nicelight/Brain_Ring-/left_right_buttons/GyverPanelWiFi-master/pcb/lamp8266.png

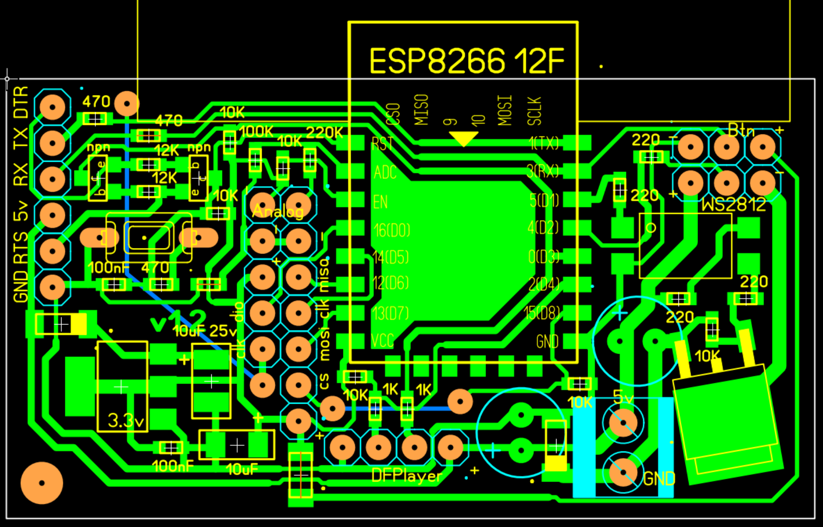
left_right_buttons/GyverPanelWiFi-master/pcb/lamp8266.png
