nicelight/Brain_Ring-/left_right_buttons/GyverPanelWiFi-master/proj_img.jpg

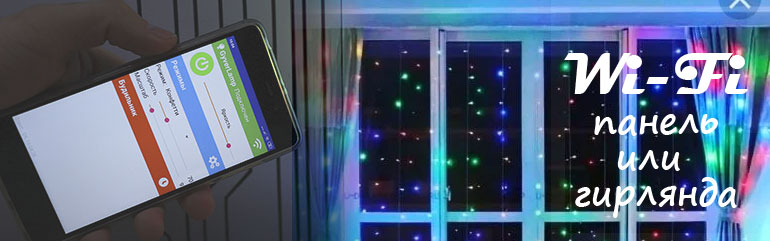
left_right_buttons/GyverPanelWiFi-master/proj_img.jpg
