nicelight/Brain_Ring-/left_right_buttons/GyverPanelWiFi-master/schemes/convertor.png

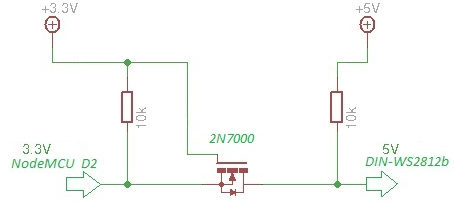
left_right_buttons/GyverPanelWiFi-master/schemes/convertor.png
