nicelight/Brain_Ring-/left_right_buttons/GyverPanelWiFi-master/schemes/ESP32_ALL.JPG

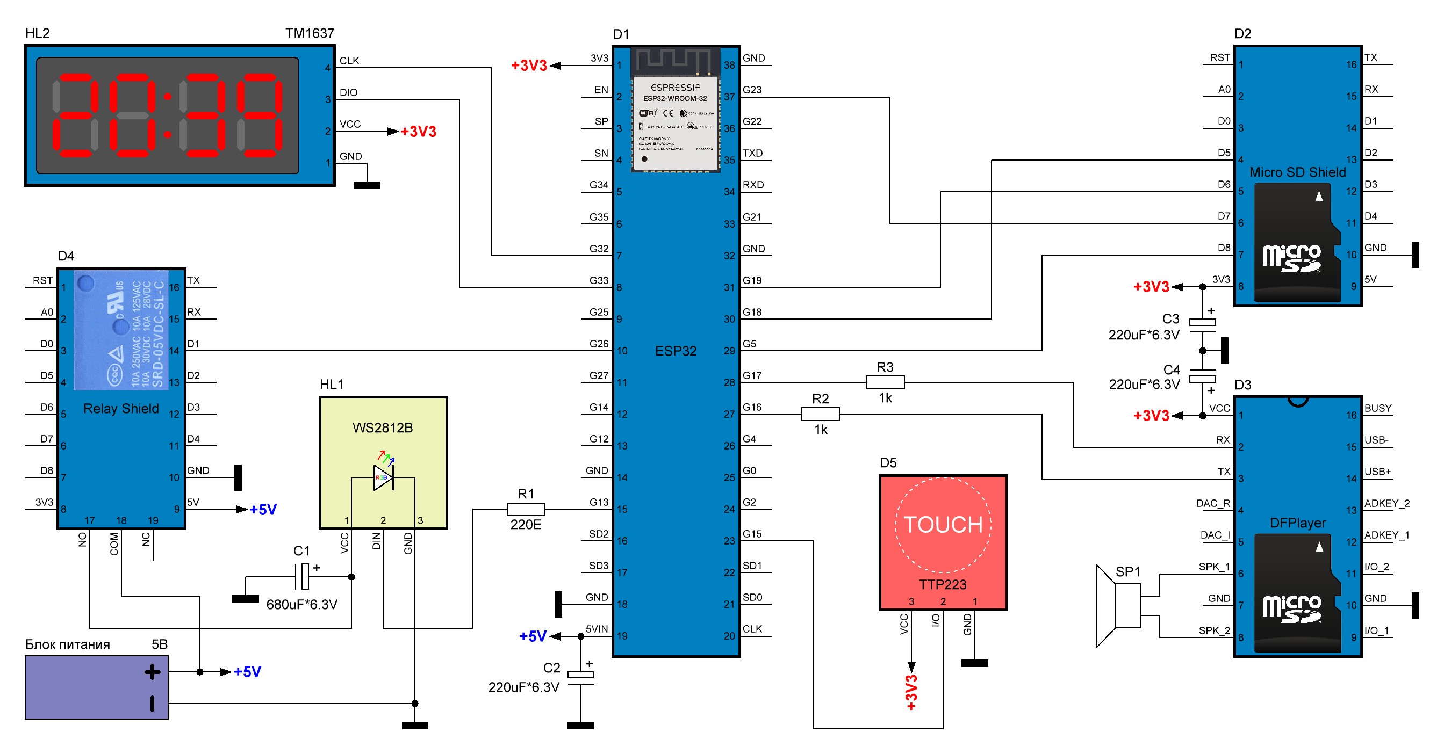
left_right_buttons/GyverPanelWiFi-master/schemes/ESP32_ALL.JPG
