nicelight/Brain_Ring-/left_right_buttons/GyverPanelWiFi-master/schemes/ESP32_button_noRELAY.jpg

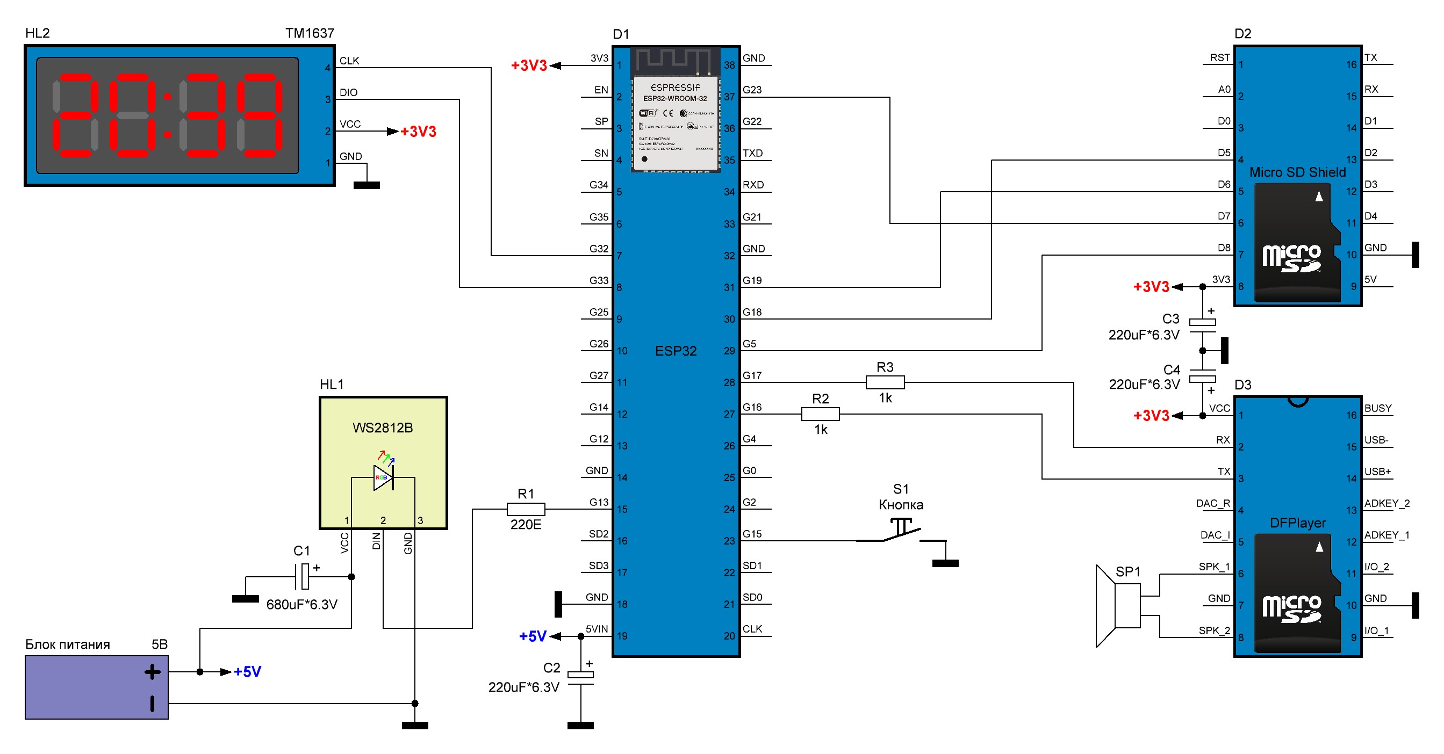
left_right_buttons/GyverPanelWiFi-master/schemes/ESP32_button_noRELAY.jpg
