nicelight/Brain_Ring-/left_right_buttons/GyverPanelWiFi-master/schemes/ESP8266_ALL.jpg

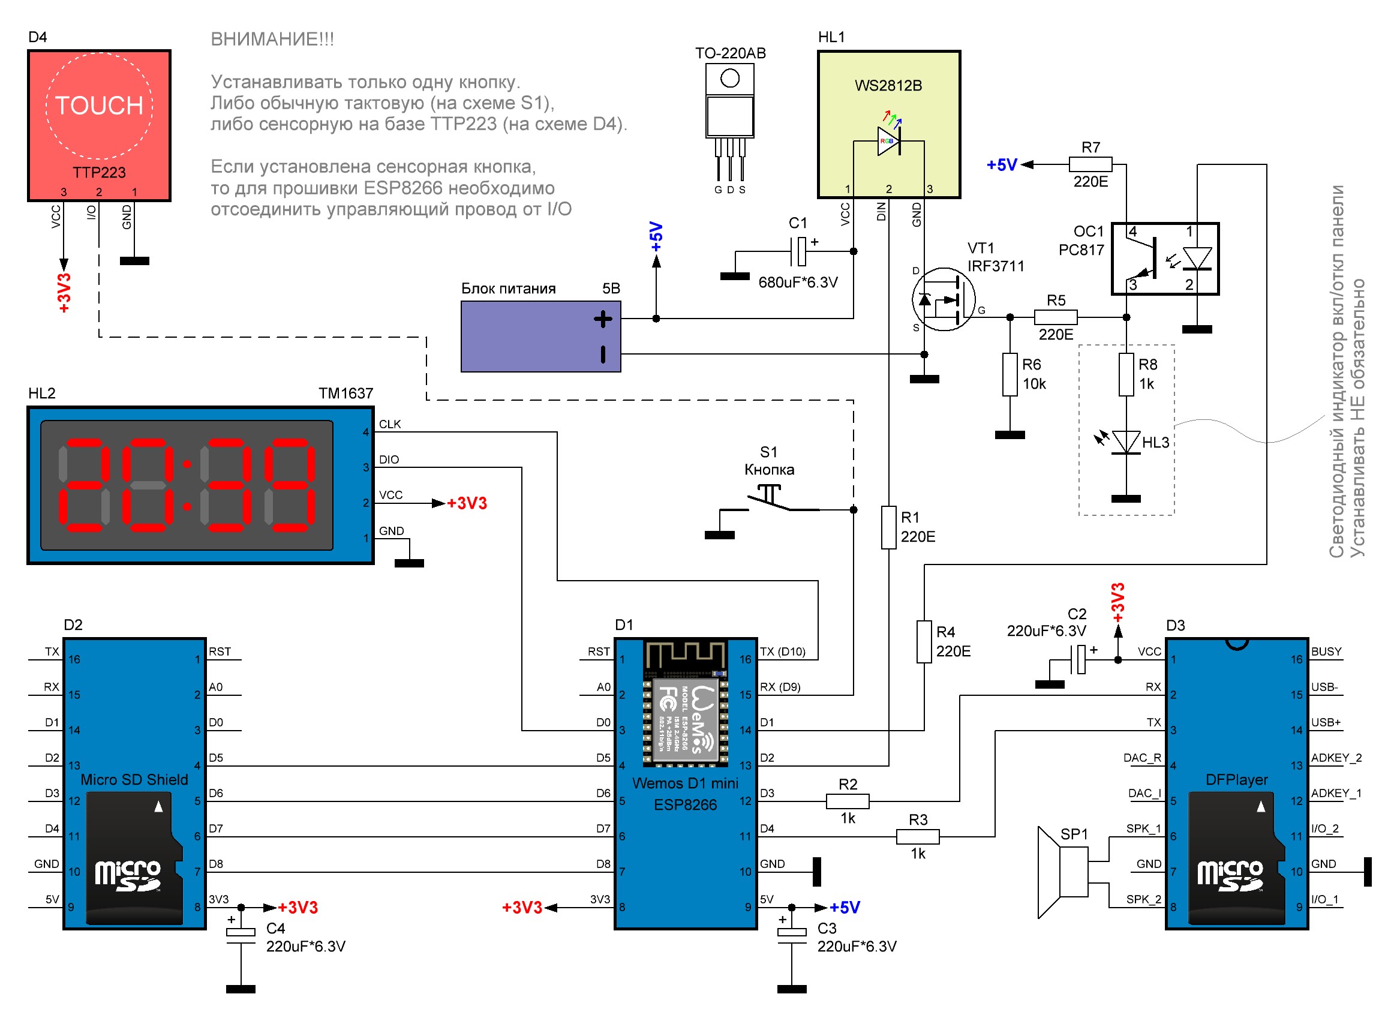
left_right_buttons/GyverPanelWiFi-master/schemes/ESP8266_ALL.jpg
