nicelight/Brain_Ring-/left_right_buttons/GyverPanelWiFi-master/schemes/ESP8266_RELAY.jpg

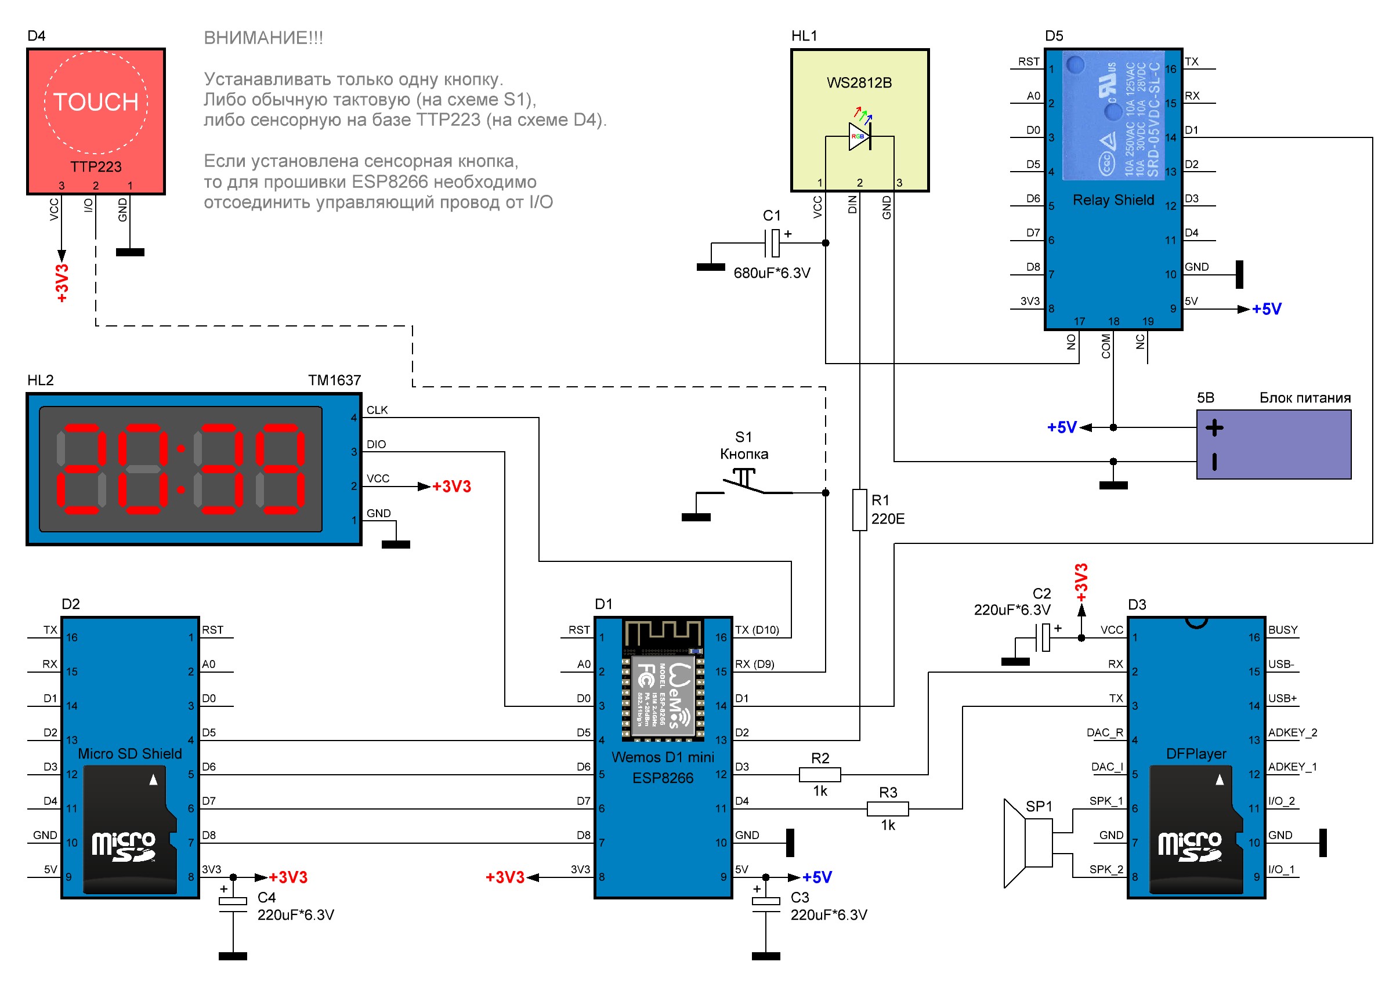
left_right_buttons/GyverPanelWiFi-master/schemes/ESP8266_RELAY.jpg
