nicelight/Brain_Ring-/left_right_buttons/GyverPanelWiFi-master/schemes/mosfet2.jpg

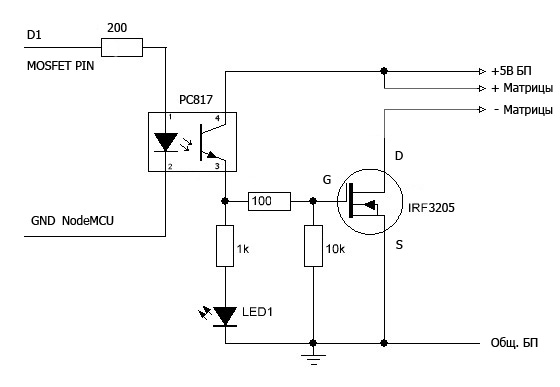
left_right_buttons/GyverPanelWiFi-master/schemes/mosfet2.jpg
