nicelight/Brain_Ring-/left_right_buttons/GyverPanelWiFi-master/schemes/mosfet.jpg

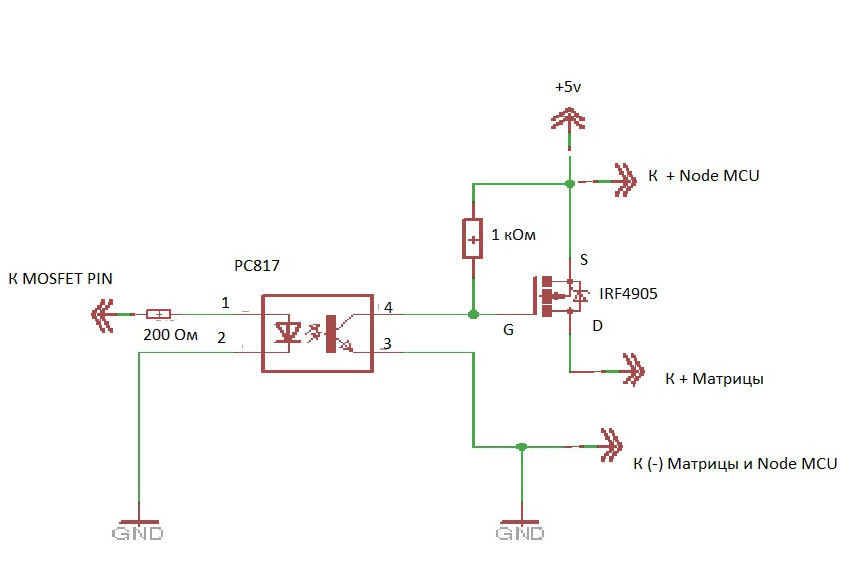
left_right_buttons/GyverPanelWiFi-master/schemes/mosfet.jpg
