nicelight/Brain_Ring-/left_right_buttons/GyverPanelWiFi-master/schemes/nodemcu.png

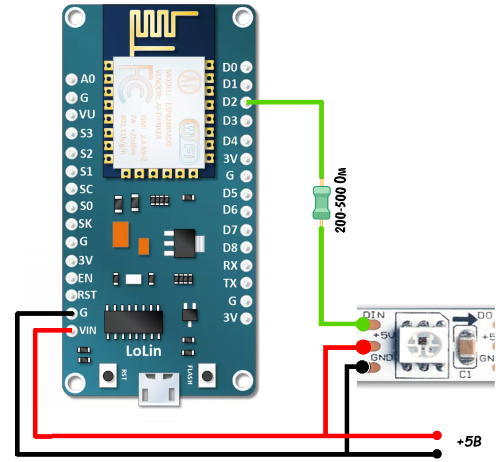
left_right_buttons/GyverPanelWiFi-master/schemes/nodemcu.png
