nicelight/Brain_Ring-/left_right_buttons/GyverPanelWiFi-master/schemes/scheme1,1.jpg

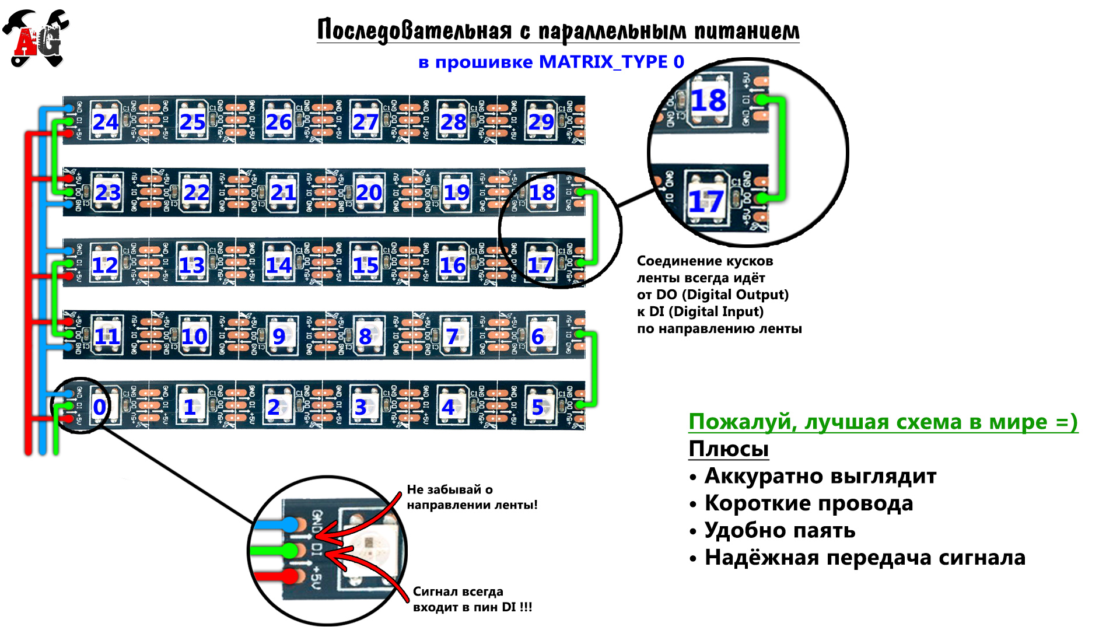
left_right_buttons/GyverPanelWiFi-master/schemes/scheme1,1.jpg
