nicelight/Brain_Ring-/left_right_buttons/GyverPanelWiFi-master/schemes/scheme3.jpg

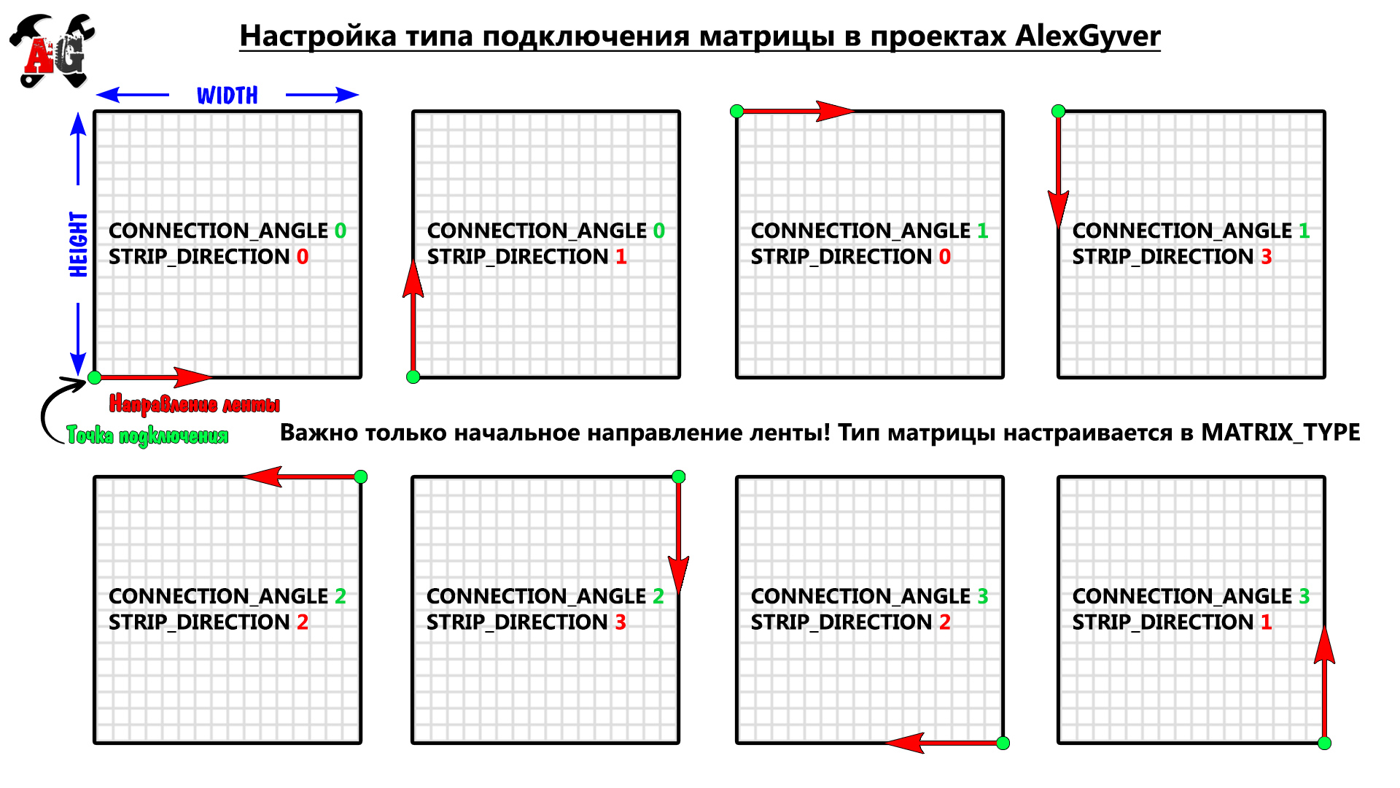
left_right_buttons/GyverPanelWiFi-master/schemes/scheme3.jpg
