nicelight/Brain_Ring-/left_right_buttons/GyverPanelWiFi-master/schemes/scheme.jpg

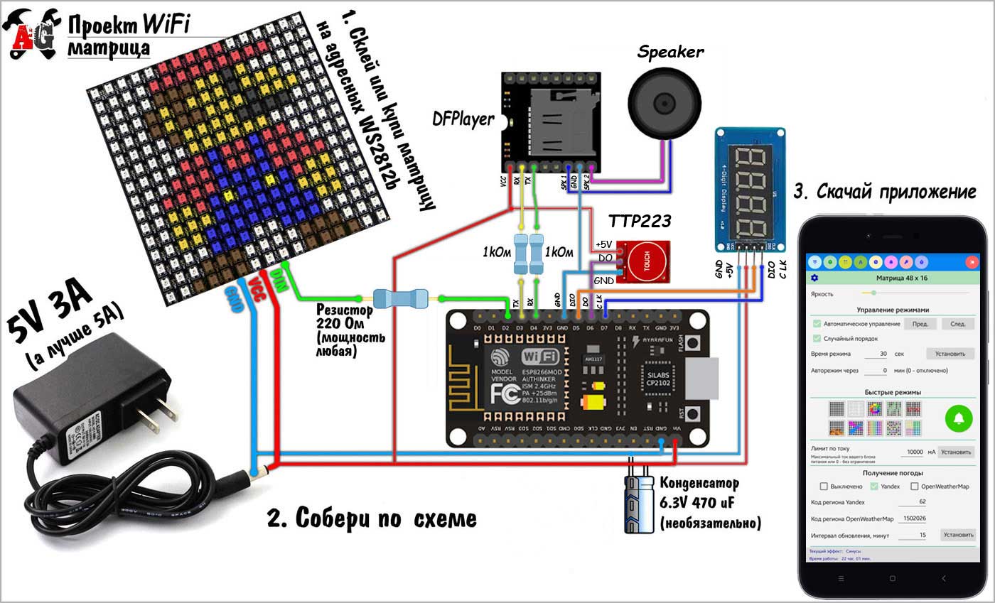
left_right_buttons/GyverPanelWiFi-master/schemes/scheme.jpg
