nicelight/Brain_Ring-/left_right_buttons/GyverPanelWiFi-master/schemes/scheme_d.jpg

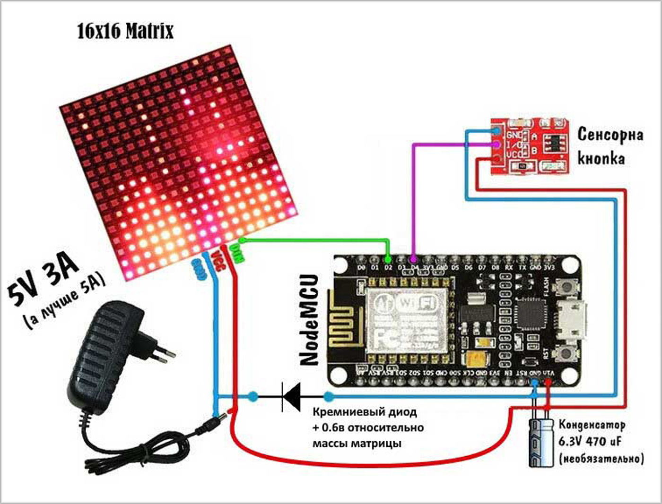
left_right_buttons/GyverPanelWiFi-master/schemes/scheme_d.jpg
