nicelight/Brain_Ring-/left_right_buttons/GyverPanelWiFi-master/schemes/schemes.png

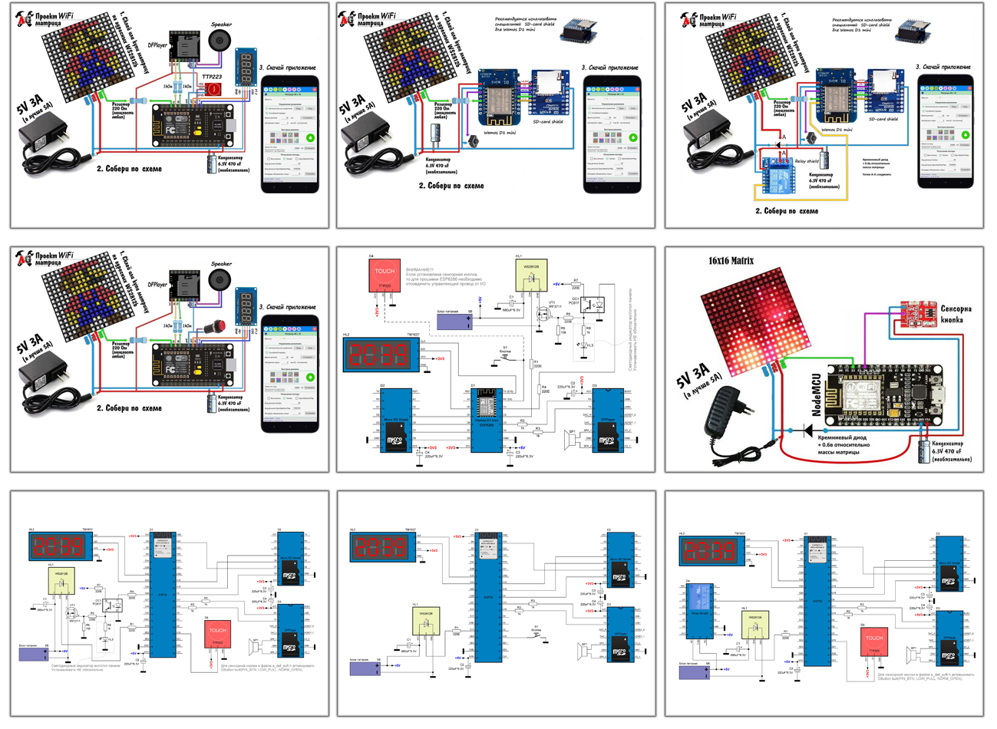
left_right_buttons/GyverPanelWiFi-master/schemes/schemes.png
