nicelight/Brain_Ring-/roof/miniJack2.5mm_pinout.png

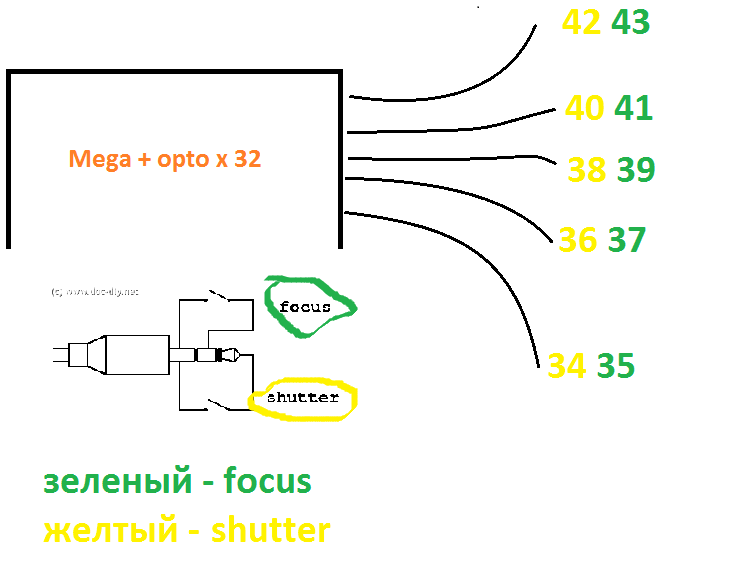
roof/miniJack2.5mm_pinout.png
