nicelight/Brain_Ring-/roof/miniJack_3.5mm_pinout.png

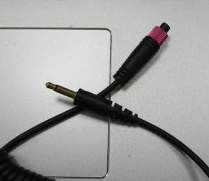
roof/miniJack_3.5mm_pinout.png
