nicelight/Brain_Ring-/roof/pc817_jacks2.jpg

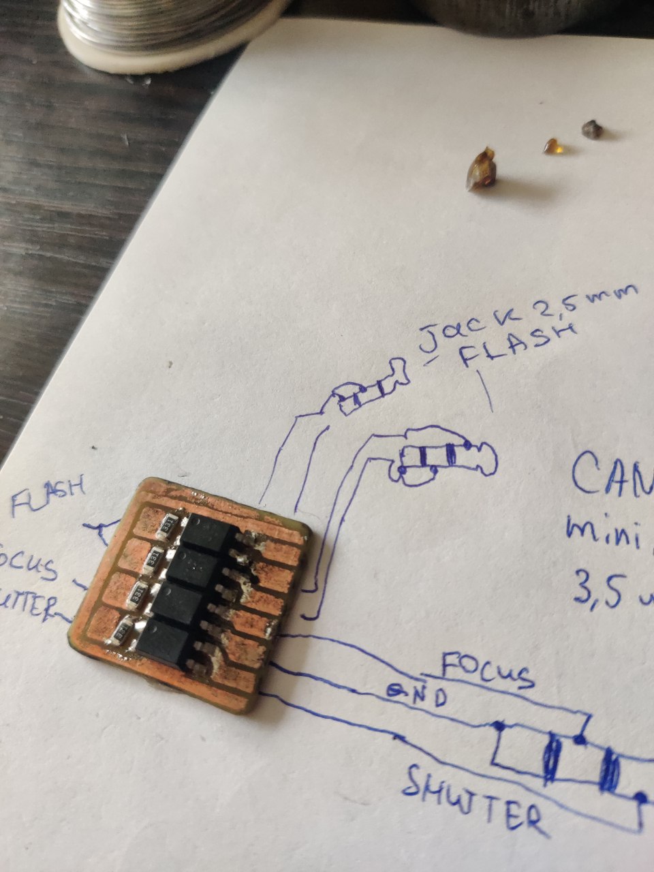
roof/pc817_jacks2.jpg
