nicelight/Brain_Ring-/roof/pc817_jacks.jpg

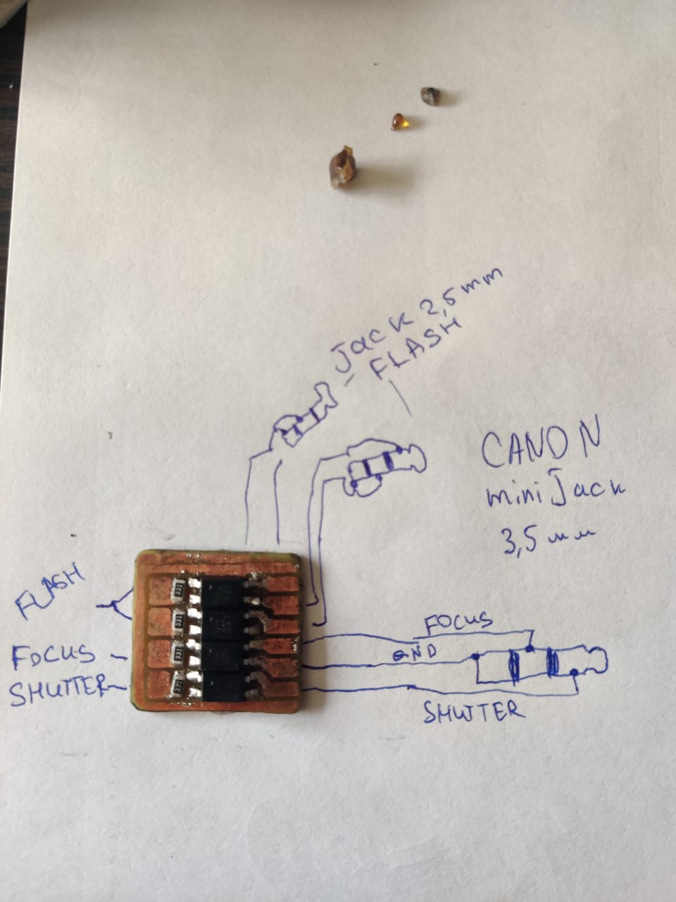
roof/pc817_jacks.jpg
