nicelight/Brain_Ring-/roof/pc817_pinout.jpg

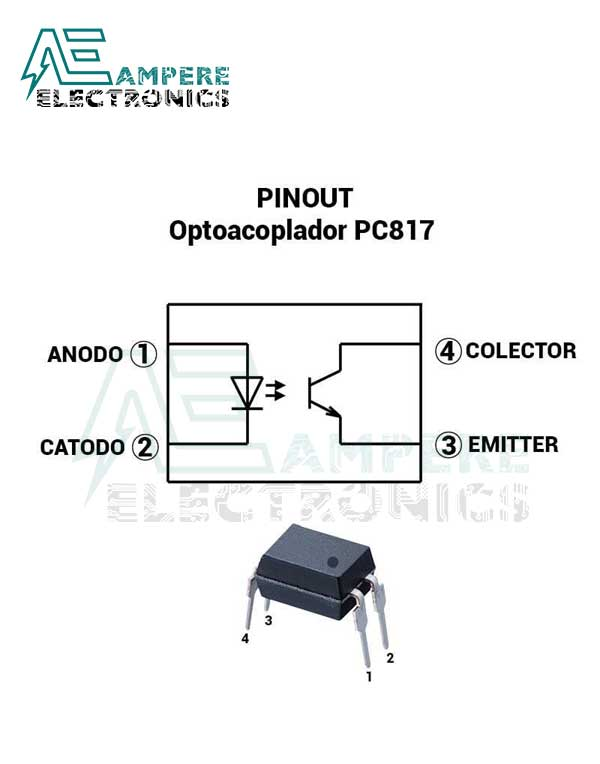
roof/pc817_pinout.jpg
