nicelight/Brain_Ring-/roof/ws2812_sacrifice_con_ESP32.png

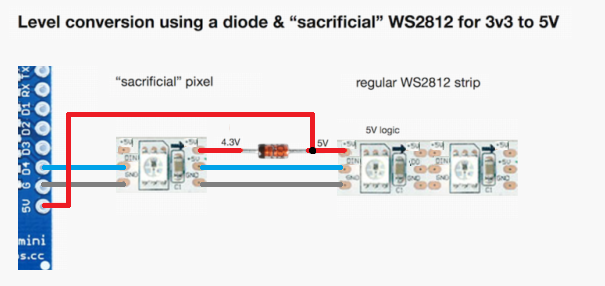
roof/ws2812_sacrifice_con_ESP32.png
