nicelight/Brain_Ring-/left_right_buttons/GyverPanelWiFi-master/firmware/GyverPanelWiFi_v1.13/a_main.ino

// ----------------------------------------------------

// Контроль времени цикла
uint32_t last_ms = millis();
int32_t ccnt;

// Отладка приема пакетов E1.31
#if (USE_E131 == 1)
bool flag_1 = false;
bool flag_2 = false;
#endif

void process() {

  // Время прохода одного цикла
  uint16_t duration = millis() - last_ms;

  if (duration > 0) {
    last_ms = millis();
    //DEBUG(F("duration="));
    //DEBUGLN(duration);
  }


  // принимаем данные
  parsing();

#if (USE_E131 == 1)
  streaming = e131 != NULL && (workMode == MASTER || (workMode == SLAVE && (e131_wait_command || ((!e131->isEmpty() || (millis() - e131_last_packet <= E131_TIMEOUT))))));
  if (!e131_streaming && streaming) {
    flag_1 = false;
    flag_2 = false;

    // Передать на ведомые устройства группы начальные установочные параметры синхронизации
    if (workMode == MASTER) {
      DEBUGLN(F("Запуск вещания E1.31 потока"));
      commandSetDimension(pWIDTH, pHEIGHT);
      commandTurnOnOff(isTurnedOff);
      commandSetBrightness(globalBrightness);
      commandSetSpecialBrightness(specialBrightness);
      if (syncMode == COMMAND) {
        commandSetCurrentTime(hour(), minute(), second(), day(), month(), year());
        commandSetGlobalColor(globalColor);
        commandSetTextSpeed(textScrollSpeed);
        commandSetClockSpeed(clockScrollSpeed);
        if (specialMode)
          commandSetSpecialMode(specialModeId);
        else
          commandSetMode(thisMode);
      }
    } else {
      masterWidth = 0;
      masterHeight = 0;
      if (syncMode == COMMAND)
        DEBUGLN(F("Ожидание поступления потока команд E1.31...\n"));
      else
        DEBUGLN(F("Ожидание поступления потока данных E1.31...\n"));
    }

    prevWorkMode = workMode;
    prevSyncMode = syncMode;
    prevSyncGroup = syncGroup;

#if (USE_MQTT == 1)
    DynamicJsonDocument doc(256);
    String out;
    doc["act"]   = F("E131");
    doc["mode"]  = workMode == MASTER ? F("MASTER") : F("SLAVE");
    doc["type"]  = syncMode == PHYSIC ? F("PHYSIC") : (syncMode == LOGIC ? F("LOGIC") : F("COMMAND"));
    doc["group"] = syncGroup;
    doc["run"]   = true;
    serializeJson(doc, out);
    SendMQTT(out, TOPIC_E131);
#endif
    FastLED.clear();
  }
  if (e131_streaming && !streaming) {
    if (prevWorkMode == MASTER)
      DEBUGLN(F("Останов вещания E1.31 потока"));
    else
      DEBUGLN(F("Останов слушателя E1.31 потока"));
#if (USE_MQTT == 1)
    DynamicJsonDocument doc(256);
    String out;
    doc["act"]   = F("E131");
    doc["mode"]  = prevWorkMode == MASTER ? F("MASTER") : F("SLAVE");
    doc["type"]  = prevSyncMode == PHYSIC ? F("PHYSIC") : (prevSyncMode == LOGIC ? F("LOGIC") : F("COMMAND"));
    doc["group"] = prevSyncGroup;
    doc["run"]   = false;
    serializeJson(doc, out);
    SendMQTT(out, TOPIC_E131);
#endif
  }
  e131_streaming = streaming;
#endif


  // Если включен эффект с кодом большим кол-ва эффектов (но меньшим кода специальных эффектов) -
  // выбрать случайный эффект, иначе будет отображаться черный экран или застывший предыдущий эффект
  if (thisMode >= MAX_EFFECT && thisMode < SPECIAL_EFFECTS_START) {
    setRandomMode();
  }

  // Эффект сменился?  tmpSaveMode - эффект, который был на предыдущем шаге цикла, thisMode - текущий эффект
  if (tmpSaveMode != thisMode) {
    if (effect_name.length() == 0) {
      // Если режим отсутствует в списке эффектов - имя пустое - включить случайный,
      // на следующем цикле tmpSaveMode != thisMode - имя будет определено снова
      setRandomMode();
    } else {
#if (USE_E131 == 1)
      if (!(e131_streaming && workMode == SLAVE)) {
#endif
#if (USE_MQTT == 0)
        DEBUGLN(String(F("Режим: ")) + effect_name);
#else
        if (!useMQTT || !mqtt.connected()) {
          DEBUGLN(String(F("Режим: ")) + effect_name);
        }
#endif
#if (USE_E131 == 1)
      }
#endif
      tmpSaveMode = thisMode;
    }
  }

  // на время принятия данных матрицу не обновляем!
  if (!parseStarted) {

    // Раз в час выполнять пересканирование текстов бегущих строк на наличие события непрерывного отслеживания.
    // При сканировании события с нечеткими датами (со звездочками) просматриваются не далее чем на сутки вперед
    // События с более поздним сроком не попадут в отслеживание. Поэтому требуется периодическое перестроение списка.
    // Сканирование требуется без учета наличия соединения с интернетом и значения флага useNTP - время может быть установлено вручную с телефона
    if (init_time && (millis() - textCheckTime > SECS_PER_HOUR * 1000L)) {
      rescanTextEvents();
    }

    if (wifi_connected) {

      // Если настройки программы предполагают синхронизацию с NTP сервером и время пришло - выполнить синхронизацию
      if (useNtp) {
        if ((ntp_t > 0) && getNtpInProgress && (millis() - ntp_t > 5000)) {
          DEBUGLN(F("Таймаут NTP запроса!"));
          ntp_cnt++;
          getNtpInProgress = false;
          if (init_time && ntp_cnt >= 10) {
            DEBUGLN(F("Не удалось установить соединение с NTP сервером."));
            refresh_time = false;
          }

#if (USE_MQTT == 1)
          DynamicJsonDocument doc(256);
          String out;
          doc["act"]         = F("TIME");
          doc["server_name"] = ntpServerName;
          doc["server_ip"]   = timeServerIP.toString();
          doc["result"]      = F("TIMEOUT");
          serializeJson(doc, out);
          SendMQTT(out, TOPIC_TME);
#endif
        }

        bool timeToSync = ntpSyncTimer.isReady();
        if (timeToSync) {
          ntp_cnt = 0;
          refresh_time = true;
        }
        if (timeToSync || (refresh_time && (ntp_t == 0 || (millis() - ntp_t > 30000)) && (ntp_cnt < 10 || !init_time))) {
          ntp_t = millis();
          getNTP();
        }
      }

#if (USE_WEATHER == 1)
      if (useWeather > 0) {
        // Если настройки программы предполагают получение сведений о текущей погоде - выполнить обновление данных с погодного сервера
        if ((weather_t > 0) && getWeatherInProgress && (millis() - weather_t > 5000)) {
          DEBUGLN(F("Таймаут запроса погоды!"));
          getWeatherInProgress = false;
          weather_cnt++;
          refresh_weather = true; weather_t = 0;
          if (init_weather && weather_cnt >= 10) {
            DEBUGLN(F("Не удалось установить соединение с сервером погоды."));
            refresh_weather = false;
            init_weather = false;

#if (USE_MQTT == 1)
            DynamicJsonDocument doc(256);
            String out;
            doc["act"]    = F("WEATHER");
            doc["region"] = useWeather == 1 ? regionID : regionID2;
            doc["result"] = F("TIMEOUT");
            serializeJson(doc, out);
            SendMQTT(out, TOPIC_WTR);
#endif
          }
        }

        bool timeToGetWeather = weatherTimer.isReady();
        if (timeToGetWeather) {
          weather_cnt = 0;
          weather_t = 0;
          refresh_weather = true;
        }
        // weather_t - время последней отправки запроса. Запрашивать погоду если weather_t обнулено или если последний (неудачный) запрос произошел не менее чем минуту назад
        // иначе слишком частые запросы нарушают коммуникацию с приложением - устройство все время блокирующе запрашивает данные с сервера погоды
        if (timeToGetWeather || (refresh_weather && (weather_t == 0 || (millis() - weather_t > 60000)) && (weather_cnt < 10 || !init_weather))) {
          weather_t = millis();
          getWeatherInProgress = true;
          getWeather();
          if (weather_cnt >= 10) {
            if (init_weather) {
              udp.flush();
            } else {
              weather_cnt = 0;
            }
          }
        }
      }
#endif
    }

#if (USE_WEATHER == 1)
    // Если погода не смогла обновиться дважды за период обновления погоды + 30сек "запаса" - считать погоду неинициализированной и не отображать погоду в часах
    if (useWeather > 0 && init_weather && (millis() - weather_time > weatherActualityDuration * 3600L * 1000L)) {
      init_weather = false;
      refresh_weather = true;
    }
#endif

    if (init_time && !(wifi_connected && useNtp)) {
      // Если нет соединения WiFi (возможно работает в режиме AP) - вместо запроса текущего времени интернета
      // выполнить (пере)расчет времени рассвета, т.к. если рассвет выключить вручную до наступления времени будильника -
      // следующее время рассвета считается неправильно. В часах без подключения к интернету и синхронизации времени с NTP сервера
      // рассвет на следующий день не срабатывает, т.к. рассчитан неправильно
      bool timeToSync = ntpSyncTimer.isReady();
      if (timeToSync) calculateDawnTime();
    }

    bool needProcessEffect = true;

#if (USE_E131 == 1)

    // Если сработал будильник - отрабатывать его эффект, даже если идет стриминг с мастера
    if (workMode == SLAVE && (e131_streaming || e131_wait_command) && (!(isAlarming || isPlayAlarmSound))) {
      needProcessEffect = e131_wait_command;
      // Если идет прием потока данных с MASTER-устройства - проверить наличие пакета от мастера
      if (e131 && !e131->isEmpty()) {
        // Получен пакет данных.
        e131_last_packet = millis();
        e131->pull(&e131_packet);

        idleTimer.reset();

        uint16_t CURRENT_UNIVERSE = htons(e131_packet.universe);

        /*
          // Отладка: информация о полученном E1.31 пакете
          Serial.printf("Universe %u / %u Channels | Packet#: %u / Errors: %u\n",
                  CURRENT_UNIVERSE,                            // The Universe for this packet
                  htons(e131_packet.property_value_count) - 1, // Start code is ignored, we're interested in dimmer data
                  e131->stats.num_packets,                     // Packet counter
                  e131->stats.packet_errors);                  // Packet error counter
        */

        /*
          // Отладка: вывод данных структуры полученного пакета E1.31 для первых двух вселенных
          if (!flag_1 && CURRENT_UNIVERSE == 1 || !flag_2 && CURRENT_UNIVERSE == 2) {
          printE131packet(&e131_packet);
          flag_1 |= CURRENT_UNIVERSE == 1;
          flag_2 |= CURRENT_UNIVERSE == 2;
          }
        */

        /*
            Serial.print(CURRENT_UNIVERSE);
            Serial.print(",");
            ccnt++;
            if (ccnt>60) {
              Serial.println();
              ccnt=0;
            }
        */

        bool isCommand = isCommandPacket(&e131_packet);
        if (isCommand && syncMode == COMMAND) e131_wait_command = true;

        // Если задан расчет FPS выводимых данных потока E1.31 - рассчитать и вывести в консоль
        if (syncMode != COMMAND && E131_FPS_INTERVAL > 0) {
          if (CURRENT_UNIVERSE == START_UNIVERSE && !isCommand) frameCnt++;
          if (millis() - last_fps_time >= E131_FPS_INTERVAL) {
            last_fps_time = millis();
            DEBUG(F("FPS: "));
            DEBUGLN(1000.0 * frameCnt / E131_FPS_INTERVAL);
            frameCnt = 0;
          }
        }

        // Если пакет содержит команду - обработать ее
        if (isCommand) {
          processCommandPacket(&e131_packet);
          needProcessEffect = syncMode == COMMAND;
        } else
          // Если режим стрима - PHYSIC или LOGIC - вывести принятые данные на матрицу
          // Физический вывод на матрицу выполнять при получении ПЕРВОГО (НАЧАЛЬНОГО) пакета группы,
          // подразумевая что на предыдущем шаге все принятые пакеты уже разобраны и цвета помещены в массив leds[] - то есть полный кадр сформирован
          // Для всех остальных пакетов - просто разбирать их и помещать принятые данные части кадра в массив leds[];
          // Если дожидаться последнего пакета группы и только потом выводить - для MASTER матриц чей размер меньше SLAVE - последний пакет не придет никогда
          // и будет создаваться впечатление "зависшей" матрицы - нет вывода. Конечно, в этом случае при несовпадении размеров матриц MASTER и SLAVE
          // быдет выведена "каша", но хотя бы видно, что устройство не зависло...
          if (syncMode == PHYSIC || syncMode == LOGIC) {
            if (CURRENT_UNIVERSE == START_UNIVERSE) FastLED.show();
            drawE131frame(&e131_packet, syncMode);
          }
      }
    }

#endif

    if (needProcessEffect) {
      // Сформировать и вывести на матрицу текущий демо-режим
      // При яркости = 1 остаются гореть только красные светодиоды и все эффекты теряют вид.
      // поэтому отображать эффект "ночные часы"
      uint8_t br = specialMode ? specialBrightness : globalBrightness;
      if (br == 1 && !(loadingFlag || isAlarming || thisMode == MC_TEXT || thisMode == MC_DRAW || thisMode == MC_LOADIMAGE)) {
        if (allowHorizontal || allowVertical)
          customRoutine(MC_CLOCK);
        else
          FastLED.clear();
      } else {
        customRoutine(thisMode);
      }
    }

    clockTicker();

    checkAlarmTime();
    checkAutoMode1Time();
    checkAutoMode2Time();
    checkAutoMode3Time();
    checkAutoMode4Time();
#if (USE_WEATHER == 1)
    checkAutoMode5Time();
    checkAutoMode6Time();
#endif

    butt.tick();  // обязательная функция отработки. Должна постоянно опрашиваться
    uint8_t clicks = 0;

    // Один клик
    if (butt.isSingle()) clicks = 1;
    // Двойной клик
    if (butt.isDouble()) clicks = 2;
    // Тройной клик
    if (butt.isTriple()) clicks = 3;
    // Четверной и более клик
    if (butt.hasClicks()) clicks = butt.getClicks();

    // Максимальное количество нажатий - 5-кратный клик
    // По неизвестными причинам (возможно ошибка в библиотеке GyverButtons)
    // getClicks() возвращает 179, что абсолютная ерунда
    if (clicks > 4) clicks = 0;

    if (butt.isPress()) {
      // Состояние - кнопку нажали
    }

    if (butt.isRelease()) {
      // Состояние - кнопку отпустили
      isButtonHold = false;
    }

    if (butt.isHolded()) {
      isButtonHold = true;
      if (globalBrightness == 255)
        brightDirection = false;
      else if (globalBrightness == 0)
        brightDirection = true;
      else
        brightDirection = !brightDirection;
    }

    if (clicks > 0) {
      DEBUG(F("Кнопка нажата "));
      DEBUG(clicks);
      DEBUGLN(F(" раз"));
    }

    // Любое нажатие кнопки останавливает будильник
    if ((isAlarming || isPlayAlarmSound) && (isButtonHold || clicks > 0)) {
      DEBUG(F("Выключение будильника кнопкой."));
      stopAlarm();
      clicks = 0;
    }

    // Одинарный клик - включить . выключить панель
    if (clicks == 1) {
      turnOnOff();
    }

    // Прочие клики работают только если не выключено
    if (isTurnedOff) {
      // Выключить питание матрицы
#if (USE_POWER == 1)
      if (!isAlarming) {
        digitalWrite(POWER_PIN, POWER_OFF);
      } else {
        digitalWrite(POWER_PIN, POWER_ON);
      }
#endif
      //  - длительное нажатие кнопки включает яркий белый свет
#if (DEVICE_TYPE == 0)
      if (isButtonHold) {
        // Включить панель - белый цвет
        set_specialBrightness(255);
        set_globalBrightness(255);
        set_globalColor(0xFFFFFF);
        isButtonHold = false;
        setSpecialMode(1);
        FastLED.setBrightness(globalBrightness);
      }
#else
      // Удержание кнопки повышает / понижает яркость панели (лампы)
      if (isButtonHold && butt.isStep()) {
        processButtonStep();
      }
#endif

    } else {

      // Включить питание матрицы
#if (USE_POWER == 1)
      digitalWrite(POWER_PIN, POWER_ON);
#endif

      // Был двойной клик - следующий эффект, сброс автоматического переключения
      if (clicks == 2) {
        bool tmpSaveSpecial = specialMode;
        resetModes();
        setManualModeTo(true);
        if (tmpSaveSpecial)
          setRandomMode();
        else
          nextMode();
      }

      // Тройное нажатие - включить случайный режим с автосменой
      else if (clicks == 3) {
        // Включить демо-режим
        resetModes();
        setManualModeTo(false);
        setRandomMode();
      }

      // Если устройство - лампа
#if (DEVICE_TYPE == 0)
      // Четверное нажатие - включить белую лампу независимо от того была она выключена или включен любой другой режим
      if (clicks == 4) {
        // Включить лампу - белый цвет
        set_specialBrightness(255);
        set_globalBrightness(255);
        set_globalColor(0xFFFFFF);
        setSpecialMode(1);
        FastLED.setBrightness(globalBrightness);
      }
      // Пятикратное нажатие - показать текущий IP WiFi-соединения
      else if (clicks == 5) {
        showCurrentIP(false);
      }
#else
      // Четырехкратное нажатие - показать текущий IP WiFi-соединения
      else if (clicks == 4) {
        showCurrentIP(false);
      }
#endif
      // ... и т.д.

      // Обработка нажатой и удерживаемой кнопки
      else if (isButtonHold && butt.isStep() && thisMode != MC_DAWN_ALARM) {
        // Удержание кнопки повышает / понижает яркость панели (лампы)
        processButtonStep();
      }
    }

    // Проверить - если долгое время не было ручного управления - переключиться в автоматический режим
    if (!(isAlarming || isPlayAlarmSound)) checkIdleState();

    // Если есть несохраненные в EEPROM данные - сохранить их
    if (saveSettingsTimer.isReady()) {
      saveSettings();
    }
  }
}

String getEffectName(int8_t mode) {
  String ef_name = "";
  switch (mode) {
    case MC_CLOCK:
      if (isNightClock)
        ef_name = F("Ночные часы");
      else
        ef_name = F("Часы");
      break;
    case MC_TEXT:
      ef_name = F("Бегущая строка");
      break;
    case MC_LOADIMAGE:
      ef_name = F("Загрузка изображения");
      break;
    case MC_DRAW:
      ef_name = F("Рисование");
      break;
    case -1:
      ef_name = "";
      break;
    default:
      // Определить какой эффект включился
      String s_tmp = String(EFFECT_LIST);
      uint16_t len1 = s_tmp.length();
      s_tmp = GetToken(s_tmp, thisMode + 1, ',');
      uint16_t len2 = s_tmp.length();
      if (len1 > len2) {
        ef_name = s_tmp;
      } else {
        // Если режим отсутствует в списке эффектов - имя не определено
        ef_name = "";
      }
      break;
  }
  return ef_name;
}

void processButtonStep() {
  if (brightDirection) {
    if (globalBrightness < 10) set_globalBrightness(globalBrightness + 1);
    else if (globalBrightness < 250) set_globalBrightness(globalBrightness + 5);
    else {
      set_globalBrightness(255);
    }
  } else {
    if (globalBrightness > 15) set_globalBrightness(globalBrightness - 5);
    else if (globalBrightness > 1) set_globalBrightness(globalBrightness - 1);
    else {
      set_globalBrightness(1);
    }
  }
  set_specialBrightness(globalBrightness);
  if (!isTurnedOff) FastLED.setBrightness(globalBrightness);
}

// ********************* ПРИНИМАЕМ ДАННЫЕ **********************

void parsing() {

  // ****************** ОБРАБОТКА *****************
  String  str, str1, str2;
  char c;
  bool    err = false;
  int32_t pntX, pntY, pntColor, pntIdx, idx;
  String  pictureLine;
  uint8_t alarmHourVal, alarmMinuteVal, b_tmp;
  int8_t  tmp_eff;

  // Программа передает изображение в матрицу по стороне с меньшей длиной, чтобы избежать переполнение буфера приема
  // Если ширина матрицы больше чем ее высота - передача будет происходить по колонкам слева направо
  // Если ширина матрицы меньше чем ее высота - передача будет происходить по строкам сверху вниз
  String pntPart[minDim];

  /*
    Протокол связи, посылка начинается с режима. Режимы:
    1 - Включение / выключение устройства
     - $1 0; - выключить
     - $1 1; - включить
     - $1 2; - переключить
    2 - Настройка типа и размера матрицы, угла ее подключения, количество сегментов
       - $2 M0 M1 M2 M3 M4 M5 M6 M7 M8 M9 M11
             M0  - ширина сегмента матрицы 1..127
             M1  - высота сегмента матрицы 1..127
             M2  - тип сегмента матрицы - 0 - зигзаг; 1 _ параллельная; 2 - использовать карту индексов
             M3  - угол подключения диодов в сегменте: 0 - левый нижний, 1 - левый верхний, 2 - правый верхний, 3
             M4  - направление ленты из угла сегмента: 0 - вправо, 1 - вверх, 2 - влево, 3 - вниз
             M5  - количество сегментов в ширину составной матрицы
             M6  - количество сегментов в высоту составной матрицы
             M7  - соединение сегментов составной матрицы: 0 - зигзаг, 1 - параллельная
             M8  - угол 1-го сегмента мета-матрицы: 0 - левый нижний, 1 - левый верхний, 2 - правый верхний, 3 - правый нижний
             M9  - направление следующих сегментов мета-матрицы из угла: 0 - вправо, 1 - вверх, 2 - влево, 3 - вниз
             M11 - индекс текущей карты индексов в случае M2 == 2
    3 - управление играми из приложение WiFi Panel Player
      - $3 0;   включить на устройстве демо-режим
      - $3 1;   включить игру "Лабиринт" в режиме ожидания начала игры
      - $3 2;   включить игру "Змейка" в режиме ожидания начала игры
      - $3 3;   включить игру "Тетрис" в режиме ожидания начала игры
      - $3 4;   включить игру "Арканоид" в режиме ожидания начала игры
      - $3 10 - кнопка вверх
      - $3 11 - кнопка вправо
      - $3 12 - кнопка вниз
      - $3 13 - кнопка влево
      - $3 14 - центральная кнопка джойстика (ОК)
    4 - яркость -
      $4 0 value   установить текущий уровень общей яркости
    5 - рисование
      - $5 0 RRGGBB; - установить активный цвет рисования в формате RRGGBB
      - $5 1;        - очистить матрицу (заливка черным)
      - $5 2;        - заливка матрицы активным активным цветом рисования
      - $5 3 X Y;    - рисовать точку активным цветом рисования в позицию X Y
      - $5 4;        - запрос текущей картинки с матрицы в телефон
      - $5 5 X;      - запрос списка файлов картинок X: 0 - с FS, 1 - SD
    6 - текст $6 N|some text, где N - назначение текста;
        0 - текст бегущей строки $6 0|X|text - X - 0..9,A..Z - индекс строки
        1 - имя сервера NTP
        2 - SSID сети подключения
        3 - пароль для подключения к сети
        4 - имя точки доступа
        5 - пароль к точке доступа
        6 - настройки будильников
        7 - строка запрашиваемых параметров для процедуры getStateString(), например - "CE|CC|CO|CK|NC|SC|C1|DC|DD|DI|NP|NT|NZ|NS|DW|OF"
        8 - имя сервера MQTT
        9 - имя пользователя MQTT
       10 - пароль к MQTT-серверу
       11 - картинка построчно $6 11|Y colorHEX X|colorHEX X|...|colorHEX X;
       12 - картинка по колонкам $6 12|X colorHEX Y|colorHEX Y|...|colorHEX Y;
       13 - префикс топика сообщения к MQTT-серверу
       14 - текст бегущей строки для немедленного отображения без сохранения $6 14|text
       15 - Загрузить пользовательскую картинку из файла на матрицу; $6 15|ST|filename; ST - "FS" - файловая система; "SD" - карточка
       16 - Сохранить текущее изображение с матрицы в файл $6 16|ST|filename; ST - "FS" - файловая система; "SD" - карточка
       17 - Удалить файл $6 16|ST|filename; ST - "FS" - файловая система; "SD" - карточка
    8 - эффект
      - $8 0 N; включить эффект N
      - $8 1 N D; D -> параметр #1 для эффекта N;
      - $8 2 N X; вкл/выкл использовать в демо-режиме; N - номер эффекта, X=0 - не использовать X=1 - использовать
      - $8 3 N D; D -> параметр #2 для эффекта N;
      - $8 4 N X; вкл/выкл оверлей текста поверх эффекта; N - номер эффекта, X=0 - выкл X=1 - вкл
      - $8 5 N X; вкл/выкл оверлей часов поверх эффекта; N - номер эффекта, X=0 - выкл X=1 - вкл
      - $8 6 N D; D -> контрастность эффекта N;
    11 - Настройки MQTT-канала (см. также $6 для N=8,9,10)
      - $11 1 X;   - использовать управление через MQTT сервер X; 0 - не использовать; 1 - использовать
      - $11 2 D;   - порт MQTT
      - $11 5;     - Разорвать подключение к MQTT серверу, чтобы он мог переподключиться с новыми параметрами
    12 - Настройки погоды
      - $12 3 X;   - использовать цвет для отображения температуры X=0 - выкл X=1 - вкл в дневных часах
      - $12 4 X;   - использовать получение погоды с погодного сервера
      - $12 5 I С C2; - интервал получения погоды с сервера в минутах (I) и код региона C - Yandex и код региона C2 - OpenWeatherMap
      - $12 6 X;   - использовать цвет для отображения температуры X=0 - выкл X=1 - вкл в ночных часах
    13 - Настройки бегущей cтроки
      - $13 1 N;   - активация прокручивания строки с номером N 0..35
      - $13 2 N;   - запросить текст бегущей строки с индексом N 0..35 как есть, без обработки макросов - ответ TY
      - $13 9 D;   - сохранить настройку I - интервал в секундах отображения бегущей строки
      - $13 11 X;  - Режим цвета бегущей строки X: 0,1,2,
      - $13 13 X;  - скорость прокрутки бегущей строки
      - $13 15 00FFAA; - цвет текстовой строки для режима "монохромный", сохраняемый в globalTextColor
      - $13 18 X; - сохранить настройку X "Бегущая строка в эффектах" (общий, для всех эффектов), где X: 0 - отключено; 1 - включено
    14 - быстрая установка ручных режимов с пред-настройками
       - $14 0;  Черный экран (выкл);
       - $14 1;  Белый экран (освещение);
       - $14 2;  Цветной экран;
       - $14 3;  Огонь;
       - $14 4;  Конфетти;
       - $14 5;  Радуга;
       - $14 6;  Матрица;
       - $14 7;  Светлячки;
       - $14 8;  Часы ночные;
       - $14 9;  Часы бегущей строкой;
       - $14 10; Часы простые;
    15 - скорость $15 скорость таймер; 0 - таймер эффектов
    16 - Режим смены эффектов: $16 value; N: 0 - ручной режим;  1 - авторежим; 2 - PrevMode; 3 - NextMode; 5 - вкл/выкл случайный выбор следующего режима
    17 - Время автосмены эффектов и бездействия: $17 сек сек;
    18 - Запрос текущих параметров программой: $18 page; page - страница настройки в программе на смартфоне (1..7) или специальный параметр (91..99)
         page 1:  // Настройки
         page 2:  // Эффекты
         page 3:  // Настройки бегущей строки
         page 4:  // Настройки часов
         page 5:  // Настройки будильника
         page 6:  // Настройки подключения
         page 7:  // Настройки режимов автовключения по времени
         page 10: // Загрузка картинок
         page 11: // Рисование
         page 12: // Игры
         page 91: // Запрос текста бегущей строки как есть без обработки макросов
         page 92: // Запрос текста бегущей строки с обработкой макросов для заполнения списка в программе
         page 93: // Запрос списка звуков будильника
         page 94: // Запрос списка звуков рассвета
         page 95: // Ответ состояния будильника - сообщение по инициативе сервера
         page 96: // Ответ демо-режима звука - сообщение по инициативе сервера
         page 99: // Запрос списка эффектов
    19 - работа с настройками часов
      - $19 1 X; - сохранить настройку X "Часы в эффектах"
      - $19 2 X; - Использовать синхронизацию часов NTP  X: 0 - нет, 1 - да
      - $19 3 N Z; - Период синхронизации часов NTP и Часовой пояс
      - $19 4 X; - Выключать индикатор TM1637 при выключении экрана X: 0 - нет, 1 - да
      - $19 5 X; - Режим цвета часов оверлея X: 0,1,2,3
      - $19 6 X; - Ориентация часов  X: 0 - горизонтально, 1 - вертикально
      - $19 7 X; - Размер часов X: 0 - авто, 1 - малые 3х5, 2 - большие 5x7
      - $19 8 YYYY MM DD HH MM; - Установить текущее время YYYY.MM.DD HH:MM
      - $19 9 X; - Показывать температуру вместе с малыми часами 1 - да; 0 - нет
      - $19 10 X; - Цвет ночных часов:  0 - R; 1 - G; 2 - B; 3 - C; 3 - M; 5 - Y; 6 - W;
      - $19 11 X; - Яркость ночных часов:  0..255
      - $19 12 X; - скорость прокрутки часов оверлея или 0, если часы остановлены по центру
      - $19 14 00FFAA; - цвет часов оверлея, сохраняемый в globalClockColor
      - $19 16 X; - Показывать дату в режиме часов  X: 0 - нет, 1 - да
      - $19 17 D I; - Продолжительность отображения даты / часов (в секундах)
      - $19 18 HH MM TT; - Установить указанное время HH:MM и температуру TT - для отладки позиционирования часов с температурой
    20 - настройки и управление будильников
      - $20 0;       - отключение будильника (сброс состояния isAlarming)
      - $20 2 X VV MA MB;
           X    - исп звук будильника X=0 - нет, X=1 - да
          VV    - максимальная громкость
          MA    - номер файла звука будильника
          MB    - номер файла звука рассвета
      - $20 3 X NN VV; - пример звука будильника
           X - 1 играть 0 - остановить
          NN - номер файла звука будильника из папки SD:/01
          VV - уровень громкости
      - $20 4 X NN VV; - пример звука рассвета
           X - 1 играть 0 - остановить
          NN - номер файла звука рассвета из папки SD:/02
          VV - уровень громкости
      - $20 5 VV; - установить уровень громкости проигрывания примеров (когда уже играет)
          VV - уровень громкости
    21 - настройки подключения к сети / точке доступа
      - $21 0 X - использовать точку доступа: X=0 - не использовать X=1 - использовать
      - $21 1 IP1 IP2 IP3 IP4 - установить статический IP адрес подключения к локальной WiFi сети, пример: $21 1 192 168 0 106
      - $21 2; Выполнить переподключение к сети WiFi
    22 - настройки включения режимов матрицы в указанное время
       - $22 HH1 MM1 NN1 HH2 MM2 NN2 HH3 MM3 NN3 HH4 MM4 NN4
             HHn - час срабатывания
             MMn - минуты срабатывания
             NNn - эффект: -3 - выключено; -2 - выключить матрицу; -1 - ночные часы; 0 - случайный режим и далее по кругу; 1 и далее - список режимов EFFECT_LIST
    23 - прочие настройки
       - $23 0 VAL  - лимит по потребляемому току
       - $23 1 ST   - Сохранить EEPROM в файл    ST = 0 - внутр. файл. систему; 1 - на SD-карту
       - $23 2 ST   - Загрузить EEPROM из файла  ST = 0 - внутр. файл. системы; 1 - на SD-карты
       - $23 3 E1 E2 E3   - Установка режима работы панели и способа трактовки полученных данных синхронизации
             E1 - режим работы 0 - STANDALONE; 1 - MASTER; 2 - SLAVE
             E2 - данные в кадре: 0 - физическое расположение цепочки диодов
                                  1 - логическое расположение - X,Y - 0,0 - левый верхний угол и далее вправо по X, затем вниз по Y
                                  2 - payload пакета - строка команды
             E3 - группа синхронизации 0..9
  */

  // Если прием данных завершен и управляющая команда в intData[0] распознана
  if (recievedFlag && intData[0] > 0 && intData[0] <= 23) {
    recievedFlag = false;

    // Режимs 18 и 6.7  не сбрасывают idleTimer
    // Другие режимы сбрасывают таймер бездействия
    if (!(intData[0] == 18 || (intData[0] == 6 && intData[1] == 7))) {
      idleTimer.reset();
    }

    switch (intData[0]) {

      // ----------------------------------------------------
      // 1 - Включение / выключение устройства
      //   - $1 0; - выключить
      //   - $1 1; - включить
      //   - $1 2; - переключить

      case 1:
        if (intData[1] == 0) {
          // Выключить устройство
          turnOff();
          sendPageParams(1, cmdSource);
        } else if (intData[1] == 1) {
          // Включить устройство
          turnOn();
          sendPageParams(1, cmdSource);
        } else if (intData[1] == 2) {
          // Переключить устройство
          turnOnOff();
          sendPageParams(1, cmdSource);
        }
        else {
#if (USE_MQTT == 1)
          notifyUnknownCommand(incomeBuffer);
#endif
        }
        break;

      // ----------------------------------------------------
      // 2 - Настройка типа и размера матрицы, угла ее подключения, количество сегментов
      //     - $2 M0 M1 M2 M3 M4 M5 M6 M7 M8 M9 M11
      //       M0  - ширина сегмента матрицы 1..127
      //       M1  - высота сегмента матрицы 1..127
      //       M2  - тип сегмента матрицы - 0 - зигзаг; 1 - параллельная; 2 - карта индексов
      //       M3  - угол подключения диодов в сегменте: 0 - левый нижний, 1 - левый верхний, 2 - правый верхний, 3
      //       M4  - направление ленты из угла сегмента: 0 - вправо, 1 - вверх, 2 - влево, 3 - вниз
      //       M5  - количество сегментов в ширину составной матрицы
      //       M6  - количество сегментов в высоту составной матрицы
      //       M7  - соединение сегментов составной матрицы: 0 - зигзаг, 1 - параллельная
      //       M8  - угол 1-го сегмента мета-матрицы: 0 - левый нижний, 1 - левый верхний, 2 - правый верхний, 3 - правый нижний
      //       M9  - направление следующих сегментов мета-матрицы из угла: 0 - вправо, 1 - вверх, 2 - влево, 3 - вниз
      //       M11 - индекс файла карты индексов в массиве mapFiles (при M2 == 2)

      case 2:
        // Установить новые параметры, которые вступят в силу после перезагрузки устройства
        putMatrixSegmentWidth(intData[1]);
        putMatrixSegmentHeight(intData[2]);
        putMatrixSegmentType(intData[3]);
        putMatrixSegmentAngle(intData[4]);
        putMatrixSegmentDirection(intData[5]);

        putMetaMatrixWidth(intData[6]);
        putMetaMatrixHeight(intData[7]);
        putMetaMatrixType(intData[8]);
        putMetaMatrixAngle(intData[9]);
        putMetaMatrixDirection(intData[10]);

        idx = (byte)intData[11];
        if (mapListLen > 0 && idx >= 0 && idx < mapListLen) {
          String file_name = mapFiles[idx]; // 32x16
          int8_t p = file_name.lastIndexOf("x");
          if (p >= 0) {
            mapWIDTH = file_name.substring(0, p).toInt();
            mapHEIGHT = file_name.substring(p + 1).toInt();
            if (mapWIDTH < 8) mapWIDTH = 8;
            if (mapHEIGHT < 8) mapHEIGHT = 8;
            if (mapWIDTH > 127) mapWIDTH = 127;
            if (mapHEIGHT > 127) mapHEIGHT = 127;
            putMatrixMapWidth(mapWIDTH);
            putMatrixMapHeight(mapHEIGHT);
          }
        }

        saveSettings();
        FastLED.clear();
        FastLED.show();

        // После небольшой задержки перезагрузить контроллер
        delay(500);
        ESP.restart();
        break;

      // ----------------------------------------------------
      // 3 - управление играми из приложение WiFi Panel Player
      //   - $3 0;   включить на устройстве демо-режим
      //   - $3 1;   включить игру "Лабиринт" в режиме ожидания начала игры
      //   - $3 2;   включить игру "Змейка" в режиме ожидания начала игры
      //   - $3 3;   включить игру "Тетрис" в режиме ожидания начала игры
      //   - $3 4;   включить игру "Арканоид" в режиме ожидания начала игры
      //   - $3 10 - кнопка вверх
      //   - $3 11 - кнопка вправо
      //   - $3 12 - кнопка вниз
      //   - $3 13 - кнопка влево
      //   - $3 14 - центральная кнопка джойстика (ОК)
      // ----------------------------------------------------

      case 3:
        if (intData[1] == 0) {
          // Включить на устройстве демо-режим
          FastLED.clear();
          FastLEDshow();
          delay(50);
          setManualModeTo(false);
          nextMode();
          sendAcknowledge(cmdSource);
        } else if (intData[1] == 1) {
          // Игра "Лабиринт"
          setManualModeTo(true);
          setEffect(MC_MAZE);
          gameDemo = false;
          gamePaused = true;
          sendPageParams(12, cmdSource);
        } else if (intData[1] == 2) {
          // Игра "Змейка"
          setManualModeTo(true);
          setEffect(MC_SNAKE);
          gameDemo = false;
          gamePaused = true;
          sendPageParams(12, cmdSource);
        } else if (intData[1] == 3) {
          // Игра "Тетрис"
          setManualModeTo(true);
          setEffect(MC_TETRIS);
          gameDemo = false;
          gamePaused = true;
          sendPageParams(12, cmdSource);
        } else if (intData[1] == 4) {
          // Игра "Арканоид"
          setManualModeTo(true);
          setEffect(MC_ARKANOID);
          gameDemo = false;
          gamePaused = true;
          sendPageParams(12, cmdSource);
        } else if (intData[1] == 10) {
          // кнопка вверх
          buttons = 0;
          gamePaused = false;
          sendAcknowledge(cmdSource);
        } else if (intData[1] == 11) {
          // кнопка вправо
          buttons = 1;
          gamePaused = false;
          sendAcknowledge(cmdSource);
        } else if (intData[1] == 12) {
          // кнопка вниз
          buttons = 2;
          gamePaused = false;
          sendAcknowledge(cmdSource);
        } else if (intData[1] == 13) {
          // кнопка влево
          buttons = 3;
          gamePaused = false;
          sendAcknowledge(cmdSource);
        } else if (intData[1] == 14) {
          // кнопка влево
          buttons = 5;
          gamePaused = false;
          sendAcknowledge(cmdSource);
        }
        else {
#if (USE_MQTT == 1)
          notifyUnknownCommand(incomeBuffer);
#endif
        }
        break;

      // ----------------------------------------------------
      // 4 - яркость -
      //  $4 0 value   установить текущий уровень общей яркости / яркости ночных часов
      // ----------------------------------------------------

      case 4:
        if (intData[1] == 0) {
          // При включенном режиме ночных часов ползунок яркости регулирует только яркость ночных часов
          // Для прочих режимов - общую яркость системы
          if (isNightClock) {
            set_nightClockBrightness(intData[2]); // setter
            set_specialBrightness(nightClockBrightness);
            FastLED.setBrightness(specialBrightness);
          } else {
            set_globalBrightness(intData[2]);
            if (specialMode) set_specialBrightness(globalBrightness);
            if (!isTurnedOff) FastLED.setBrightness(globalBrightness);
            if (thisMode == MC_DRAW || thisMode == MC_LOADIMAGE) {
              FastLEDshow();
            }
          }
          // Для команд, пришедших от MQTT отправлять только ACK;
          // Для команд, пришедших от UDP отправлять при необходимости другие данные, например - состояние элементов управления на странице от которой пришла команда
          sendAcknowledge(cmdSource);
        } else {
#if (USE_MQTT == 1)
          notifyUnknownCommand(incomeBuffer);
#endif
        }
        break;

      // ----------------------------------------------------
      // 5 - рисование
      //   $5 0 RRGGBB; - установить активный цвет рисования в формате RRGGBB
      //   $5 1;        - очистить матрицу (заливка черным)
      //   $5 2;        - заливка матрицы активным активным цветом рисования
      //   $5 3 X Y;    - рисовать точку активным цветом рисования в позицию X Y
      //   $5 4;        - запрос текущей картинки с матрицы в телефон
      //   $5 5 X;      - запрос списка файлов картинок X: 0 - с FS, 1 - SD
      // ----------------------------------------------------

      case 5:
        if (thisMode != MC_DRAW) {
          set_thisMode(MC_DRAW);
          setManualModeTo(true);
        }
        if (intData[1] == 0) {
          // Установить активный цвет рисования - incomeBuffer = '$5 0 00FF00;'
          str = String(incomeBuffer).substring(5, 11);
          set_drawColor(HEXtoInt(str));
          sendAcknowledge(cmdSource);
        } else if (intData[1] == 1) {
          // Очистка матрицы (заливка черным)
          FastLED.clear();
          sendAcknowledge(cmdSource);
        } else if (intData[1] == 2) {
          // Залить матрицу активным цвет ом рисования
          fillAll(gammaCorrection(drawColor));
          sendAcknowledge(cmdSource);
        } else if (intData[1] == 3) {
          // Нарисовать точку активным цветом рисования в позиции X Y
          drawPixelXY(intData[2], intData[3], gammaCorrection(drawColor));
          sendAcknowledge(cmdSource);
        } else if (intData[1] == 4) {
          // Включить режим передачи содержимого матрицы в приложение на телефоне
          sendImageFlag = true;
          sendImageRow  = 0;
          sendImageCol  = 0;
          sendImageSrc  = cmdSource;
          sendImageLine();
        } else if (intData[1] == 5) {
          // Запрос списка файлов картинок intData[2]: 0 - с FS, 1 - с SD
          str = getStateString("FL" + String((intData[2] == 0 ? 0 : 1)));
          str = "$18 " + str + ";";
          sendStringData(str, cmdSource);
        }
        else {
#if (USE_MQTT == 1)
          notifyUnknownCommand(incomeBuffer);
#endif
        }
        break;

      // ----------------------------------------------------
      // 6 - прием строки: строка принимается в формате N|text, где N:
      //   0 - принятый текст бегущей строки $6 0|X|text - X - 0..9,A..Z - индекс строки
      //   1 - имя сервера NTP
      //   2 - имя сети (SSID)
      //   3 - пароль к сети
      //   4 - имя точки доступа
      //   5 - пароль точки доступа
      //   6 - настройки будильника в формате $6 6|DD EF WD HH1 MM1 HH2 MM2 HH3 MM3 HH4 MM4 HH5 MM5 HH6 MM6 HH7 MM7
      //   7 - строка запрашиваемых параметров для процедуры getStateString(), например - "$6 7|CE CC CO CK NC SC C1 DC DD DI NP NT NZ NS DW OF"
      //   8 - имя сервера MQTT
      //   9 - имя пользователя MQTT
      //  10 - пароль к MQTT-серверу
      //  11 - картинка построчно $6 11|Y colorHEX X|colorHEX X|...|colorHEX X;
      //  12 - картинка по колонкам $6 12|X colorHEX Y|colorHEX Y|...|colorHEX Y;   - пока не реализовано (зарезервировано)
      //  13 - префикс топика сообщения к MQTT-серверу
      //  14 - текст бегущей строки для немедленного отображения без сохранения $6 14|text
      //  15 - Загрузить пользовательскую картинку из файла на матрицу; $6 15|ST|filename; ST - "FS" - файловая система; "SD" - карточка
      //  16 - Сохранить текущее изображение с матрицы в файл $6 16|ST|filename; ST - "FS" - файловая система; "SD" - карточка
      //  17 - Удалить файл $6 16|ST|filename; ST - "FS" - файловая система; "SD" - карточка
      // ----------------------------------------------------

      case 6:
        b_tmp = 0;
        tmp_eff = receiveText.indexOf("|");
        if (tmp_eff > 0) {
          b_tmp = receiveText.substring(0, tmp_eff).toInt();
          str = receiveText.substring(tmp_eff + 1, receiveText.length() + 1);
          switch (b_tmp) {

            case 0:
              c = str[0];
              str = str.substring(2);
              str.replace('\r', ' ');
              str.replace('\n', ' ');
              str.trim();
              tmp_eff = getTextIndex(c); // '0'..'9','A'..'Z' -> 0..35
              if (tmp_eff >= 0) {
                textLines[tmp_eff] = str;
              }
              if (tmp_eff == 0 && textLines[0] == "#") {
                textLines[0] = "##";
              }
              saveTexts();
              rescanTextEvents();

              // Отправить уведомление об изменениях в строке
              editIdx = tmp_eff;             // На время вызова sendPageParams(91) editIdx должен указывать на строку в массиве
              sendPageParams(91, cmdSource); // Обработать указанную строку
              break;

            case 1:
              set_ntpServerName(str);
              if (wifi_connected) {
                refresh_time = true; ntp_t = 0; ntp_cnt = 0;
              }
              break;

            case 2:
              set_Ssid(str);
              break;

            case 3:
              set_pass(str);
              break;

            case 4:
              set_SoftAPName(str);
              break;

            case 5:
              set_SoftAPPass(str);
              // Передается в одном пакете - использовать SoftAP, имя точки и пароль
              // После получения пароля - перезапустить создание точки доступа
              if (useSoftAP) startSoftAP();
              break;

            case 6:
              // Настройки будильника в формате $6 6|DD EF WD AD HH1 MM1 HH2 MM2 HH3 MM3 HH4 MM4 HH5 MM5 HH6 MM6 HH7 MM7
              // DD    - установка продолжительности рассвета (рассвет начинается за DD минут до установленного времени будильника)
              // EF    - установка эффекта, который будет использован в качестве рассвета
              // WD    - установка дней пн-вс как битовая маска
              // AD    - продолжительность "звонка" сработавшего будильника
              // HHx   - часы дня недели x (1-пн..7-вс)
              // MMx   - минуты дня недели x (1-пн..7-вс)
              //
              // Остановить будильник, если он сработал
#if (USE_MP3 == 1)
              if (isDfPlayerOk) {
                dfPlayer.stop(); delay(GUARD_DELAY);
              }
              set_soundFolder(0);
              set_soundFile(0);
#endif

              set_isAlarming(false);
              set_isAlarmStopped(false);

              // Настройки содержат 18 элементов (см. формат выше)
              tmp_eff = CountTokens(str, ' ');
              if (tmp_eff == 18) {

                set_dawnDuration(constrain(GetToken(str, 1, ' ').toInt(), 1, 59));
                set_alarmEffect(GetToken(str, 2, ' ').toInt());
                set_alarmWeekDay(GetToken(str, 3, ' ').toInt());
                set_alarmDuration(constrain(GetToken(str, 4, ' ').toInt(), 1, 10));

                for (uint8_t i = 0; i < 7; i++) {
                  alarmHourVal = constrain(GetToken(str, i * 2 + 5, ' ').toInt(), 0, 23);
                  alarmMinuteVal = constrain(GetToken(str, i * 2 + 6, ' ').toInt(), 0, 59);
                  set_alarmTime(i + 1, alarmHourVal, alarmMinuteVal);
                }

                // Рассчитать время начала рассвета будильника
                calculateDawnTime();
              }
              break;

            case 7:
              // Запрос значений параметров, требуемых приложением вида str="CE|CC|CO|CK|NC|SC|C1|DC|DD|DI|NP|NT|NZ|NS|DW|OF"
              // Каждый запрашиваемый приложением параметр - для заполнения соответствующего поля в приложении
              // Передать строку для формирования, затем отправить параметры в приложение
              if (cmdSource == UDP) {
                str = "$18 " + getStateString(str) + ";";
              } else {
#if (USE_MQTT == 1)
                // Если ключи разделены пробелом - заменить на пайпы '|'
                // Затем добавить в строку измененных параметров changed_keys
                // На следующей итерации параметры из строки changed_keys будут отправлены в канал MQTT
                str.replace(" ", "|");
                int16_t pos_start = 0;
                int16_t pos_end = str.indexOf('|', pos_start);
                int16_t len = str.length();
                if (pos_end < 0) pos_end = len;
                while (pos_start < len && pos_end >= pos_start) {
                  if (pos_end > pos_start) {
                    String key = str.substring(pos_start, pos_end);
                    if (key.length() > 0) addKeyToChanged(key);
                  }
                  pos_start = pos_end + 1;
                  pos_end = str.indexOf('|', pos_start);
                  if (pos_end < 0) pos_end = len;
                }
#endif
              }
              break;

#if (USE_MQTT == 1)
            case 8:
              set_MqttServer(str);
              break;
            case 9:
              set_MqttUser(str);
              break;
            case 10:
              set_MqttPass(str);
              break;
            case 13:
              set_MqttPrefix(str);
              break;
#endif

            // Прием строки передаваемого отображения по строкам  $6 11|Y colorHEX X|colorHEX X|...|colorHEX X;
            case 11:
              pictureLine = str;

              if (thisMode != MC_LOADIMAGE) {
                setManualModeTo(true);
                set_thisMode(MC_LOADIMAGE);
                FastLED.clear();
                FastLEDshow();
                delay(50);
              }

              // Разбираем СТРОКУ из принятого буфера формата 'Y colorHEX X|colorHEX X|...|colorHEX X'
              // Получить номер строки (Y) для которой получили строку с данными (номер строки - сверху вниз, в то время как матрица - индекс строки снизу вверх)
              b_tmp = pictureLine.indexOf(" ");
              str = pictureLine.substring(0, b_tmp);
              pntY = str.toInt();
              pictureLine = pictureLine.substring(b_tmp + 1);

              pntIdx = 0; pntX = 0;
              idx = pictureLine.indexOf("|");
              while (idx > 0)
              {
                str = pictureLine.substring(0, idx);
                pictureLine = pictureLine.substring(idx + 1);

                pntPart[pntIdx++] = str;
                idx = pictureLine.indexOf("|");

                if (idx < 0 && pictureLine.length() > 0) {
                  pntPart[pntIdx++] = pictureLine;
                }
                delay(0);
              }

              for (int32_t i = 0; i < pntIdx; i++) {
                str = pntPart[i];
                idx = str.indexOf(" ");
                str1 = str.substring(0, idx);
                str2 = str.substring(idx + 1);

                pntColor = HEXtoInt(str1);
                pntX = str2.toInt();

                // начало картинки - очистить матрицу
                if (pntX == 0 && pntY == 0) {
                  FastLED.clear();
                  FastLEDshow();
                }

                drawPixelXY(pntX, pHEIGHT - pntY - 1, gammaCorrection(pntColor));
              }

              // Выводить построчно для ускорения вывода на экран
              if (pntX == pWIDTH - 1) {
                FastLEDshow();
              }

              // Строка подтверждения приема строки изображения + восстановить переменную выбора типа строки из команды "$6 11|xxx"
              b_tmp = 11;
              str = "#L " + String(pntY) + "-" + String(pntX) + " ack" + String(ackCounter++) + ";";

              break;

            // Прием строки передаваемого отображения по колонкам $6 12|X colorHEX Y|colorHEX Y|...|colorHEX Y;   - пока не реализовано (зарезервировано)
            case 12:
              pictureLine = str;

              if (thisMode != MC_LOADIMAGE) {
                setManualModeTo(true);
                set_thisMode(MC_LOADIMAGE);
                FastLED.clear();
                FastLEDshow();
                delay(50);
              }

              // Разбираем СТРОКУ из принятого буфера формата 'X colorHEX Y|colorHEX Y|...|colorHEX Y'
              // Получить номер колонки (X) для которой получили строку с данными (номер строки - сверху вниз, в то время как матрица - индекс строки снизу вверх)
              b_tmp = pictureLine.indexOf(" ");
              str = pictureLine.substring(0, b_tmp);
              pntX = str.toInt();
              pictureLine = pictureLine.substring(b_tmp + 1);

              pntIdx = 0; pntY = 0;
              idx = pictureLine.indexOf("|");
              while (idx > 0)
              {
                str = pictureLine.substring(0, idx);
                pictureLine = pictureLine.substring(idx + 1);

                pntPart[pntIdx++] = str;
                idx = pictureLine.indexOf("|");

                if (idx < 0 && pictureLine.length() > 0) {
                  pntPart[pntIdx++] = pictureLine;
                }
                delay(0);
              }

              for (int32_t i = 0; i < pntIdx; i++) {
                str = pntPart[i];
                idx = str.indexOf(" ");
                str1 = str.substring(0, idx);
                str2 = str.substring(idx + 1);

                pntColor = HEXtoInt(str1);
                pntY = str2.toInt();

                // начало картинки - очистить матрицу
                if (pntX == 0 && pntY == 0) {
                  FastLED.clear();
                  FastLEDshow();
                }

                drawPixelXY(pntX, pHEIGHT - pntY - 1, gammaCorrection(pntColor));
              }

              // Выводить построчно для ускорения вывода на экран
              if (pntY == pHEIGHT - 1) {
                FastLEDshow();
              }

              // Строка подтверждения приема строки изображения + восстановить переменную выбора типа строки из команды "$6 11|xxx"
              b_tmp = 12;
              str = "#C " + String(pntX) + "-" + String(pntY) + " ack" + String(ackCounter++) + ";";
              break;

            case 14:
              // текст бегущей строки для немедленного отображения без сохранения
              setImmediateText(str);
              break;

            case 15:
              // Загрузка картинки: str = "TS|file", где TS - "FS" - внутр. память МК, "SD" - SD-карта; file - имя картинки без расширения
              if (thisMode != MC_DRAW) {
                set_thisMode(MC_DRAW);
                setManualModeTo(true);
              }
              str1 = USE_SD == 1 && FS_AS_SD == 0 ? str.substring(0, 2) : "FS"; // хранилище: если нет реальной SD-карты (эмуляция в FS) - использовать хранилище FS
              str2 = str.substring(3);                                         // Имя файла картинки без расширения
              str = openImage(str1, str2, nullptr, false);
              str = "$18 ERR:[" + str + "];";
              break;

            case 16:
              // Сохранение картинки: str = "TS|file", где TS - "FS" - внутр. память МК, "SD" - SD-карта; file - имя картинки без расширения
              if (thisMode != MC_DRAW) {
                set_thisMode(MC_DRAW);
                setManualModeTo(true);
              }
              str1 = USE_SD == 1 && FS_AS_SD == 0 ? str.substring(0, 2) : "FS"; // хранилище: если нет реальной SD-карты (эмуляция в FS) - использовать хранилище FS
              str2 = str.substring(3);                                         // Имя файла картинки без расширения
              str = saveImage(str1, str2);
              str = "$18 ERR:[" + str + "];";
              break;

            case 17:
              // Удаление файла: str = "TS|file", где TS - "FS" - внутр. память МК, "SD" - SD-карта; file - имя картинки без расширения
              if (thisMode != MC_DRAW) {
                set_thisMode(MC_DRAW);
                setManualModeTo(true);
              }
              str1 = USE_SD == 1 && FS_AS_SD == 0 ? str.substring(0, 2) : "FS"; // хранилище: если нет реальной SD-карты (эмуляция в FS) - использовать хранилище FS
              str2 = str.substring(3);                                         // Имя файла картинки без расширения
              str = deleteImage(str1, str2);
              str = "$18 ERR:[" + str + "];";
              break;
          }
        }

        // При сохранении текста бегущей строки (b_tmp == 0) не нужно сразу автоматически сохранять ее в EEPROM - Сохранение будет выполнено по таймеру.
        // При получении запроса параметров (b_tmp == 7) ничего сохранять не нужно - просто отправить требуемые параметры
        // При получении очередной строки изображения (b_tmp == 11 или b_tmp == 12) ничего сохранять не нужно
        // При получении текста без сохранения (b_tmp == 14) ничего сохранять не нужно
        // При загрузка / сохранение картинки (b_tmp == 15 или b_tmp == 16) ничего сохранять не нужно
        // Остальные полученные строки - сохранять сразу, ибо это настройки сети, будильники и другая критически важная информация
        switch (b_tmp) {
          case 0:
          case 7:
          case 11:
          case 12:
          case 14:
          case 15:
          case 16:
          case 17:
            // Ничего делать не нужно
            break;
          default:
            saveSettings();
            break;
        }

        if (b_tmp <= 17) {
          // Для команд, пришедших от MQTT отправлять только ACK;
          // Для команд, пришедших от UDP отправлять при необходимости другие данные, например - состояние элементов управления на странице от которой пришла команда
          if (cmdSource == UDP) {
            switch (b_tmp) {
              case 0:
                sendPageParams(3, cmdSource);
                break;
              case 6:
                sendPageParams(5, cmdSource);
                break;
              case 7:
              case 11:
              case 12:
              case 15:
              case 16:
              case 17:
                sendStringData(str, cmdSource);
                break;
              default:
                sendAcknowledge(cmdSource);
                break;
            }
          } else {
            switch (b_tmp) {
              case 11:
              case 12:
              case 15:
              case 16:
              case 17:
                sendStringData(str, cmdSource);
                break;
              default:
                // Другие команды - отправить подтверждение о выполнении
                sendAcknowledge(cmdSource);
                break;
            }
          }
        } else {
#if (USE_MQTT == 1)
          notifyUnknownCommand(incomeBuffer);
#endif
        }
        break;

      // ----------------------------------------------------
      // 8 - эффект
      //  - $8 0 N; включить эффект N
      //  - $8 1 N D; D -> параметр #1 для эффекта N;
      //  - $8 2 N X; вкл/выкл использовать в демо-режиме; N - номер эффекта, X=0 - не использовать X=1 - использовать
      //  - $8 3 N D; D -> параметр #2 для эффекта N;
      //  - $8 4 N X; вкл/выкл оверлей текста поверх эффекта; N - номер эффекта, X=0 - выкл X=1 - вкл
      //  - $8 5 N X; вкл/выкл оверлей часов поверх эффекта; N - номер эффекта, X=0 - выкл X=1 - вкл
      //  - $8 6 N D; D -> контрастность эффекта N;
      // ----------------------------------------------------

      case 8:
        tmp_eff = intData[2];
        // intData[1] : действие -> 0 - выбор эффекта;  1 - параметры #1 и #2; 2 - вкл/выкл "использовать в демо-режиме"
        // intData[2] : номер эффекта
        // intData[3] : действие = 1: значение параметра #1 или #2
        //              действие = 2: 0 - выкл; 1 - вкл;

        //Добавление для Brain Ring 2024
        // если выбран эффект моноцвет
        if((intData[1]==0) && (intData[2] == 44)){
          blinkTapButton = 1; // флаг чтобы помигать кнопкой 
        }
        
        if (intData[1] == 0) {
          // Включить эффект
          /*
            // Если в приложении выбраны часы, но они недоступны из-за размеров матрицы - брать другой случайный эффект
            if (tmp_eff == MC_CLOCK){
             if (!(allowHorizontal || allowVertical)) {
               setRandomMode();
             }
            }
          */
          // Если в приложении выбраны эффект "Ночные часы" / "Дневные часы", но они недоступны из-за размеров матрицы - выключить матрицу
          // Если в приложении выбраны часы, но они недоступны из-за размеров матрицы - брать другой случайный эффект
          if (tmp_eff == MC_CLOCK) {
            if (!(allowHorizontal || allowVertical)) {
              setRandomMode();
            } else {
              setSpecialMode(10);    // Дневные часы. Для ночных - 8
            }
          } else {
            loadingFlag = true;
            setEffect(tmp_eff);
            if (tmp_eff == MC_FILL_COLOR && globalColor == 0x000000) set_globalColor(0xffffff);
          }
          setManualModeTo(true);
        } else

          if (intData[1] == 1) {
            // Параметр #1 эффекта
            if (tmp_eff == MC_CLOCK) {
              // Параметр "Вариант" меняет цвет часов.
              if (isNightClock) {
                // Для ночных часов - полученное значение -> в map 0..6 - код цвета ночных часов
                set_nightClockColor(map(intData[3], 0, 255, 0, 6));
                set_specialBrightness(nightClockBrightness);
                FastLED.setBrightness(specialBrightness);
              } else {
                // Для дневных часов - меняется цвет часов (параметр HUE цвета, hue < 2 - белый)
                set_EffectScaleParam(tmp_eff, intData[3]);
              }
            } else {
              set_EffectScaleParam(tmp_eff,   intData[3]);
              if (tmp_eff == MC_FILL_COLOR) {
                set_globalColor(getColorInt(CHSV(effectSpeed[MC_FILL_COLOR], effectScaleParam[MC_FILL_COLOR], 255)));
              } else if (thisMode == tmp_eff && tmp_eff == MC_BALLS) {
                // При получении параметра эффекта "Шарики" (кол-во шариков) - надо переинициализировать эффект
                loadingFlag = true;
              } else if (thisMode == tmp_eff && tmp_eff == MC_RUBIK) {
                // При получении параметра эффекта "Кубик Рубика" (размер плашки) - надо переинициализировать эффект
                loadingFlag = true;
              }
            }
          } else

            if (intData[1] == 2) {
              // Вкл/выкл использование эффекта в демо-режиме
              set_EffectUsage(tmp_eff, intData[3] == 1);
              if (tmp_eff == MC_PATTERNS) {
                setTimersForMode(thisMode);
              }
            } else

              if (intData[1] == 3) {
                // Параметр #2 эффекта
                set_EffectScaleParam2(tmp_eff, intData[3]);
                if (thisMode == tmp_eff && tmp_eff == MC_RAINBOW) {
                  // При получении параметра 2 эффекта "Радуга" (тип радуги) - надо переинициализировать эффект
                  // Если установлен тип радуги - "случайный" - продолжаем показывать тот что был
                  loadingFlag = effectScaleParam2[tmp_eff] != 0;
                } else if (thisMode == tmp_eff && tmp_eff == MC_ARROWS) {
                  // При получении параметра 2 эффекта "Стрелки" -  вид - надо переинициализировать эффект
                  // Если установлен тип - "случайный" - продолжаем показывать тот что был
                  loadingFlag = effectScaleParam2[tmp_eff] != 0;
                } else if (thisMode == tmp_eff && tmp_eff == MC_PAINTBALL) {
                  // При получении параметра 2 эффекта "Пэйнтбол" (сегменты) - надо переинициализировать эффект
                  loadingFlag = true;
                } else if (thisMode == tmp_eff && tmp_eff == MC_SWIRL) {
                  // При получении параметра 2 эффекта "Водоворот" (сегменты) - надо переинициализировать эффект
                  loadingFlag = true;
                } else if (thisMode == tmp_eff && tmp_eff == MC_CYCLON) {
                  // При получении параметра 2 эффекта "Циклон" (сегменты) - надо переинициализировать эффект
                  loadingFlag = true;
                } else if (thisMode == tmp_eff && tmp_eff == MC_PATTERNS) {
                  // При получении параметра 2 эффекта "Узоры" -  вид - надо переинициализировать эффект
                  // Если установлен узор - "случайный" - продолжаем показывать тот что был
                  loadingFlag = effectScaleParam2[tmp_eff] != 0;
                } else if (thisMode == tmp_eff && tmp_eff == MC_RUBIK) {
                  // При получении параметра 2 эффекта "Кубик рубика" -  вид - надо переинициализировать эффект
                  // Если установлен вариант - "случайный" - продолжаем показывать тот что был
                  loadingFlag = effectScaleParam2[tmp_eff] != 0;
                } else if (thisMode == tmp_eff && tmp_eff == MC_STARS) {
                  // При получении параметра 2 эффекта "Звездочки" -  вид - надо переинициализировать эффект
                  // Если установлен вариант - "случайный" - продолжаем показывать тот что был
                  loadingFlag = effectScaleParam2[tmp_eff] != 0;
                }
                else if (thisMode == tmp_eff && tmp_eff == MC_TRAFFIC) {
                  // При получении параметра 2 эффекта "Трафик" -  вид - надо переинициализировать эффект
                  // Если установлен вариант - "случайный" - продолжаем показывать тот что был
                  loadingFlag = effectScaleParam2[tmp_eff] != 0;
                }
                else if (thisMode == tmp_eff && tmp_eff == MC_IMAGE) {
                  // При получении параметра 2 эффекта "Анимация" -  вид - надо переинициализировать эффект
                  // Если установлена анимация - "случайная" - продолжаем показывать тот что был
                  loadingFlag = effectScaleParam2[tmp_eff] != 0;
                }
#if (USE_SD == 1)
                else if (thisMode == tmp_eff && tmp_eff == MC_SDCARD) {
                  // При получении параметра 2 эффекта "SD-карта" -  вид - надо переинициализировать эффект
                  // Если установлен эффект - "случайный" - продолжаем показывать тот что был
                  loadingFlag = effectScaleParam2[tmp_eff] != 0;  // effectScaleParam2[tmp_eff]: 0 - случайно; 1 - последовательно; 2 и далее - привести к индексу массива списка файлов
                }
#endif
              } else

                if (intData[1] == 4) {
                  // Вкл/выкл оверлей бегущей строки поверх эффекта
                  set_EffectTextOverlayUsage(tmp_eff, intData[3] == 1);
                } else

                  if (intData[1] == 5) {
                    // Вкл/выкл оверлей часов поверх эффекта
                    set_EffectClockOverlayUsage(tmp_eff, intData[3] == 1);
                  } else

                    if (intData[1] == 6) {
                      // Контрастность эффекта
                      set_EffectContrast(tmp_eff, intData[3]);
                    }

        // Для "0","2","4","5","6" - отправляются параметры, подтверждение отправлять не нужно. Для остальных - нужно
        if (intData[1] >= 0 && intData[1] <= 6) {
          // Для команд, пришедших от MQTT отправлять только ACK;
          // Для команд, пришедших от UDP отправлять при необходимости другие данные, например - состояние элементов управления на странице от которой пришла команда
          if (cmdSource == UDP) {
            if (intData[1] != 1) {
              sendPageParams(2, cmdSource);
            } else {
              sendAcknowledge(cmdSource);
            }
          } else {
            sendAcknowledge(cmdSource);
          }
        } else {
#if (USE_MQTT == 1)
          notifyUnknownCommand(incomeBuffer);
#endif
        }
        break;

        // ----------------------------------------------------
        // 11 - Настройки MQTT-канала
        // - $11 1 X;   - использовать управление через MQTT сервер X; 0 - не использовать; 1 - использовать
        // - $11 2 D;   - Порт MQTT
        // - $11 5;     - Разорвать подключение к MQTT серверу, чтобы он мог переподключиться с новыми параметрами
        // - $11 7 D;   - интервал отправки uptime на MQTT сервер в секундах или 0, если отключено
        // ----------------------------------------------------

#if (USE_MQTT == 1)
      case 11:
        switch (intData[1]) {
          case 1:               // $11 1 X; - Использовать канал MQTT: 0 - нет; 1 - да
            set_useMQTT(intData[2] == 1);
            // Если MQTT канал только что включили - отправить туда все начальные настройки,
            // т.к. пока канал был отключен - состояние параметров изменялось, но сервер об этом не знает
            if (useMQTT) {
              nextMqttConnectTime = millis();
              mqttSendStartState();
            }
            break;
          case 2:               // $11 2 D; - Порт MQTT
            set_mqtt_port(intData[2]);
            break;
          case 5:               // $11 5;   - Сохранить изменения и переподключиться к MQTT серверу
            saveSettings();
            mqtt.disconnect();
            // Если подключаемся к серверу с другим именем и/или на другом порту -
            // простой вызов
            // mqtt.setServer(mqtt_server, mqtt_port)
            // не срабатывает - соединяемся к прежнему серверу, который был обозначен при старте программы
            // Единственный вариант - программно перезагрузить контроллер. После этого новый сервер подхватывается
            if (last_mqtt_server != String(mqtt_server) || last_mqtt_port != mqtt_port) {
              ESP.restart();
            }
            // MQTT сервер мог поменять свои настройки, переключились на другой сервер или другой аккаунт - отправить туда все начальные настройки,
            if (useMQTT) mqttSendStartState();
            break;
          default:
            err = true;
            notifyUnknownCommand(incomeBuffer);
            break;
        }
        if (!err) {
          // Для команд, пришедших от MQTT отправлять только ACK;
          // Для команд, пришедших от UDP отправлять при необходимости другие данные, например - состояние элементов управления на странице от которой пришла команда
          sendAcknowledge(cmdSource);
        }
        break;
#endif

        // ----------------------------------------------------
        // 12 - Настройки погоды
        // - $12 3 X;      - использовать цвет для отображения температуры X=0 - выкл X=1 - вкл в дневных часах
        // - $12 4 X;      - использовать получение погоды с погодного сервера
        // - $12 5 I С C2; - интервал получения погоды с сервера в минутах (I) и код региона C - Yandex и код региона C2 - OpenWeatherMap
        // - $12 6 X;      - использовать цвет для отображения температуры X=0 - выкл X=1 - вкл в ночных часах
        // ----------------------------------------------------

#if (USE_WEATHER == 1)
      case 12:
        switch (intData[1]) {
          case 3:               // $12 3 X; - Использовать отображение температуры цветом 0 - нет; 1 - да
            set_useTemperatureColor(intData[2] == 1);
            break;
          case 4:               // $12 4 X; - Использовать получение погоды с сервера 0 - нет; 1 - Yandex 2 - OpenWeatherMap
            set_useWeather(intData[2]);
            if (wifi_connected) {
              refresh_weather = true; weather_t = 0; weather_cnt = 0; init_weather = false;
            }
            if (thisMode == MC_WEATHER && !useWeather) {
              loadingFlag = true;
            }
            break;
          case 5:               // $12 5 I C C2; - Интервал обновления погоды с сервера в минутах, Код региона Yandex, Код региона OpenWeatherMap
            set_SYNC_WEATHER_PERIOD(intData[2]);
            set_regionID(intData[3]);
            set_regionID2(intData[4]);
            weatherTimer.setInterval(1000L * 60 * SYNC_WEATHER_PERIOD);
            if (wifi_connected) {
              refresh_weather = true; weather_t = 0; weather_cnt = 0;
            }
            break;
          case 6:               // $12 6 X; - Использовать отображение температуры цветом 0 - нет; 1 - да
            set_useTemperatureColorNight(intData[2] == 1);
            break;
          default:
            err = true;
#if (USE_MQTT == 1)
            notifyUnknownCommand(incomeBuffer);
#endif
            break;
        }
        if (!err) {
          // Для команд, пришедших от MQTT отправлять только ACK;
          // Для команд, пришедших от UDP отправлять при необходимости другие данные, например - состояние элементов управления на странице от которой пришла команда
          if (cmdSource == UDP) {
            sendPageParams(1, cmdSource);
          } else {
            sendAcknowledge(cmdSource);
          }
        }
        break;
#endif

      // ----------------------------------------------------
      // 13 - Настройки бегущей строки
      // - $13 1 N;   - активация прокручивания строки с номером N 0..35
      // - $13 2 N;   - запросить текст бегущей строки с индексом N 0..35 как есть, без обработки макросов - ответ TY
      // - $13 9 D;   - сохранить настройку D - интервал в секундах отображения бегущей строки
      // - $13 11 X;  - Режим цвета бегущей строки X: 0,1,2,
      // - $13 13 X;  - скорость прокрутки бегущей строки
      // - $13 15 00FFAA; - цвет текстовой строки для режима "монохромный", сохраняемый в globalTextColor
      // - $13 18 X;  - сохранить настройку X "Бегущая строка в эффектах" (общий, для всех эффектов), где X: 0 - отключено; 1 - включено
      // ----------------------------------------------------

      case 13:
        switch (intData[1]) {
          case 1:               // $13 1 N; установить строку N = 0..35 как активную отображаемую строку
            // Если строка 0 - управляющая - ее нельзя включать принудительно.
            b_tmp = intData[2] > 0 || (intData[2] == 0 && textLines[0].charAt(0) != '#');
            if (b_tmp) {
              if (thisMode == MC_TEXT) {
                setRandomMode();
              }
              nextTextLineIdx = intData[2];  // nextTextLineIdx - индекс следующей принудительно отображаемой строки
              ignoreTextOverlaySettingforEffect = true;
              fullTextFlag = true;
              textLastTime = 0;
            }
            break;
          case 2:               // $13 2 I; - Запросить исходный текст бегущей строки с индексом I 0..35 без обработки макросов
            if (intData[2] >= 0 && ((uint32_t)intData[2] < (sizeof(textLines) / sizeof(String)))) {
              editIdx = intData[2];          // На время вызова sendPageParams(91) editIdx должен указывать на строку в массиве
              sendPageParams(91, cmdSource); // Обработать указанную строку
            }
            break;
          case 9:               // $13 9 D; - Периодичность отображения бегущей строки (в секундах D)
            set_TEXT_INTERVAL(intData[2]);
            break;
          case 11:               // $13 11 X; - Режим цвета бегущей строкой X: 0,1,2,
            set_COLOR_TEXT_MODE(intData[2]);
            break;
          case 13:               // $13 13 X; - скорость прокрутки бегущей строки
            set_textScrollSpeed(255 - intData[2]);
            setTimersForMode(thisMode);
            break;
          case 15:               // $13 15 00FFAA;
            // В строке цвет - "$13 15 00FFAA;" - цвет часов текстовой строкой для режима "монохромный", сохраняемый в globalTextColor
            str = String(incomeBuffer).substring(7, 13);
            set_globalTextColor((uint32_t)HEXtoInt(str));
            break;
          case 18:               // $13 18 X; - сохранить настройку X "Бегущая строка в эффектах"
            set_textOverlayEnabled(intData[2] == 1);
            if (!textOverlayEnabled) {
              showTextNow = false;
              ignoreTextOverlaySettingforEffect = false;
            }
            break;
          default:
            err = true;
#if (USE_MQTT == 1)
            notifyUnknownCommand(incomeBuffer);
#endif
            break;
        }
        if (!err) {
          // Для команд, пришедших от MQTT отправлять только ACK;
          // Для команд, пришедших от UDP отправлять при необходимости другие данные, например - состояние элементов управления на странице от которой пришла команда
          if (cmdSource == UDP) {
            if (intData[1] != 2 && intData[1] != 3)
              sendPageParams(3, cmdSource);
            else
              // Для команды "$13 3" отправляется значение, подтверждения отправлять не нужно
              sendAcknowledge(cmdSource);
          } else {
            // Для команды "$13 3" отправляется значение, подтверждения отправлять не нужно
            if (intData[1] != 2 && intData[1] != 3) {
              sendAcknowledge(cmdSource);
            }
          }
        }
        break;

      // ----------------------------------------------------
      //  14 - быстрая установка ручных режимов с пред-настройками
      // - $14 0;  Черный экран (выкл);
      // - $14 1;  Белый экран (освещение);
      // - $14 2;  Цветной экран;
      // - $14 3;  Огонь;
      // - $14 4;  Конфетти;
      // - $14 5;  Радуга;
      // - $14 6;  Матрица;
      // - $14 7;  Светлячки;
      // - $14 8;  Часы ночные;
      // - $14 9;  Часы бегущей строкой;
      // - $14 10; Часы простые;
      // ----------------------------------------------------

      case 14:
        if (intData[1] < 0 || intData[1] >= MAX_SPEC_EFFECT) {
#if (USE_MQTT == 1)
          notifyUnknownCommand(incomeBuffer);
#endif
        } else {
          if (intData[1] == 2) {
            // Если в строке цвет - "$14 2 00FFAA;" - цвет лампы, сохраняемый в globalColor
            str = String(incomeBuffer).substring(6, 12); // $14 2 00FFAA;
            set_globalColor((uint32_t)HEXtoInt(str));
          }
          setSpecialMode(intData[1]);
          // Для команд, пришедших от MQTT отправлять только ACK;
          // Для команд, пришедших от UDP отправлять при необходимости другие данные, например - состояние элементов управления на странице от которой пришла команда
          if (cmdSource == UDP) {
            sendPageParams(1, cmdSource);
          } else {
            sendAcknowledge(cmdSource);
          }
        }
        break;

      // ----------------------------------------------------
      // 15 - скорость $15 скорость таймер; 0 - таймер эффектов
      // ----------------------------------------------------

      case 15:
        if (intData[2] == 0) {
          if (intData[1] == 255) intData[1] = 254;
          set_EffectSpeed(thisMode, 255 - intData[1]);
          if (thisMode == MC_FILL_COLOR) {
            set_globalColor(getColorInt(CHSV(effectSpeed[MC_FILL_COLOR], effectScaleParam[MC_FILL_COLOR], 255)));
          }
          setTimersForMode(thisMode);
          // Для команд, пришедших от MQTT отправлять только ACK;
          // Для команд, пришедших от UDP отправлять при необходимости другие данные, например - состояние элементов управления на странице от которой пришла команда
          sendAcknowledge(cmdSource);
        } else {
#if (USE_MQTT == 1)
          notifyUnknownCommand(incomeBuffer);
#endif
        }
        break;

      // ----------------------------------------------------
      // 16 - Режим смены эффектов: $16 value; N: 0 - ручной режим;  1 - авторежим; 2 - PrevMode; 3 - NextMode; 5 - вкл/выкл случайный выбор следующего режима
      // ----------------------------------------------------

      case 16:
        if      (intData[1] == 0) setManualModeTo(true);
        else if (intData[1] == 1) {
          resetModesExt();
          setManualModeTo(false);
        }
        else if (intData[1] == 2) prevMode();
        else if (intData[1] == 3) nextMode();
        else if (intData[1] == 5) set_useRandomSequence(intData[2] == 1);

        putCurrentManualMode(manualMode ? (int8_t)thisMode : -1);

        if (manualMode) {
          putCurrentSpecMode(-1);
        }

        if (intData[1] == 1) {
          set_idleTime(getIdleTime());
          setIdleTimer();
          if (thisMode == MC_FILL_COLOR && globalColor == 0x000000) {
            // Было выключено, режим "Лампа" с черным цветом - включить случайный режим
            setRandomMode();
          }
        }

        // Для команд, пришедших от MQTT отправлять только ACK;
        // Для команд, пришедших от UDP отправлять при необходимости другие данные, например - состояние элементов управления на странице от которой пришла команда
        if (cmdSource == UDP) {
          sendPageParams(1, cmdSource);
        } else {
          sendAcknowledge(cmdSource);
        }
        break;

      // ----------------------------------------------------
      // 17 - Время автосмены эффектов и бездействия: $17 сек
      // ----------------------------------------------------

      case 17:
        set_autoplayTime((uint32_t)intData[1] * 1000UL);   // секунды -> миллисек
        set_idleTime((uint32_t)intData[2] * 60 * 1000UL);  // минуты -> миллисек
        if (!manualMode) {
          autoplayTimer = millis();
        }
        setIdleTimer();
        // Для команд, пришедших от MQTT отправлять только ACK;
        // Для команд, пришедших от UDP отправлять при необходимости другие данные, например - состояние элементов управления на странице от которой пришла команда
        sendAcknowledge(cmdSource);
        break;

      // ----------------------------------------------------
      // 18 - Запрос текущих параметров программой: $18 page;
      //    page 0:   // ping - проверка связи
      //    page 1:   // Настройки
      //    page 2:   // Эффекты
      //    page 3:   // Настройки бегущей строки
      //    page 4:   // Настройки часов
      //    page 5:   // Настройки будильника
      //    page 6:   // Настройки подключения
      //    page 7:   // Настройки режимов автовключения по времени
      //    page 10:  // Загрузка картинок
      //    page 11:  // Рисование
      //    page 12:  // Игры
      //    page 91:  // Запрос текста бегущих строк как есть без обработки макросов
      //    page 92:  // Запрос списков звуков бегущей строки - макрос {A}
      //    page 93:  // Запрос списка звуков будильника
      //    page 94:  // Запрос списка звуков рассвета
      //    page 95:  // Ответ состояния будильника - сообщение по инициативе сервера
      //    page 96:  // Ответ демо-режима звука - сообщение по инициативе сервера
      //    page 99:  // Запрос списка эффектов
      // ----------------------------------------------------

      case 18:
        if (intData[1] == 0) { // ping
          // Если идет отправка изображения - ответ отправлять не нужно
          if (sendImageFlag)
            sendImageLine();
          else {
            /* Почему-то в момент срабатывания рассвета/будильника при наличии данной конструкции
               приложение на телефоне не может подключиться к устройству пока не закончи работать будильник
              if ((isAlarming || isPlayAlarmSound) && !isAlarmStopped) {
              sendPageParams(95);  // Параметры, статуса IsAlarming (AL:1), чтобы изменить в смартфоне отображение активности будильника
              }
            */
            sendAcknowledge(cmdSource);
          }
        } else {                          // запрос параметров страницы приложения
          // Для команд, пришедших от MQTT отправлять ответы так же как и для команд, полученных из UDP
          sendPageParams(intData[1], cmdSource);
        }
        break;

      // ----------------------------------------------------
      // 19 - работа с настройками часов
      //   $19 1 X; - сохранить настройку X "Часы в эффектах" (общий, для всех эффектов)
      //   $19 2 X; - Использовать синхронизацию часов NTP  X: 0 - нет, 1 - да
      //   $19 3 N Z; - Период синхронизации часов NTP и Часовой пояс
      //   $19 4 X; - Выключать индикатор TM1637 при выключении экрана X: 0 - нет, 1 - да
      //   $19 5 X; - Режим цвета часов оверлея X: 0,1,2,3
      //   $19 6 X; - Ориентация часов  X: 0 - горизонтально, 1 - вертикально
      //   $19 7 X; - Размер часов X: 0 - авто, 1 - малые 3х5, 2 - большие 5x7
      //   $19 8 YYYY MM DD HH MM; - Установить текущее время YYYY.MM.DD HH:MM
      //   $19 9 X; - Показывать температуру вместе с малыми часами 1 - да; 0 - нет
      //   $19 10 X; - Цвет ночных часов:  0 - R; 1 - G; 2 - B; 3 - C; 3 - M; 5 - Y; 6 - W;
      //   $19 11 X; - Яркость ночных часов:  0..255
      //   $19 12 X; - скорость прокрутки часов оверлея или 0, если часы остановлены по центру
      //   $19 14 00FFAA; - цвет часов оверлея, сохраняемый в globalClockColor
      //   $19 16 X; - Показывать дату в режиме часов  X: 0 - нет, 1 - да
      //   $19 17 D I; - Продолжительность отображения даты / часов (в секундах)
      //   $19 18 HH MM TT; - Установить указанное время HH:MM и температуру TT - для отладки позиционирования часов с температурой
      // ----------------------------------------------------

      case 19:
        switch (intData[1]) {
          case 1:               // $19 1 X; - сохранить настройку X "Часы в эффектах"
            set_clockOverlayEnabled(((CLOCK_ORIENT == 0 && allowHorizontal) || (CLOCK_ORIENT == 1 && allowVertical)) ? intData[2] == 1 : false);
            if (specialMode) specialClock = clockOverlayEnabled;
            break;
          case 2:               // $19 2 X; - Использовать синхронизацию часов NTP  X: 0 - нет, 1 - да
            set_useNtp(intData[2] == 1);
            if (wifi_connected) {
              refresh_time = true; ntp_t = 0; ntp_cnt = 0;
            }
            break;
          case 3:               // $19 3 N Z; - Период синхронизации часов NTP и Часовой пояс
            set_SYNC_TIME_PERIOD(intData[2]);
            set_timeZoneOffset((int8_t)intData[3]);
            ntpSyncTimer.setInterval(1000L * 60 * SYNC_TIME_PERIOD);
            if (wifi_connected) {
              refresh_time = true; ntp_t = 0; ntp_cnt = 0;
            }
            break;
          case 4:               // $19 4 X; - Выключать индикатор TM1637 при выключении экрана X: 0 - нет, 1 - да
            set_needTurnOffClock(intData[2] == 1);
            break;
          case 5:               // $19 5 X; - Режим цвета часов оверлея X: 0,1,2,3
            set_COLOR_MODE(intData[2]);
            break;
          case 6:               // $19 6 X; - Ориентация часов  X: 0 - горизонтально, 1 - вертикально
            set_CLOCK_ORIENT(intData[2] == 1 ? 1  : 0);
            if (allowHorizontal || allowVertical) {
              if (CLOCK_ORIENT == 0 && !allowHorizontal) set_CLOCK_ORIENT(1);
              if (CLOCK_ORIENT == 1 && !allowVertical) set_CLOCK_ORIENT(0);
            } else {
              set_clockOverlayEnabled(false);
            }
            // Центрируем часы по горизонтали/вертикали по ширине / высоте матрицы
            checkClockOrigin();
            break;
          case 7:               // $19 7 X; - Размер часов  X: 0 - авто, 1 - малые 3х5, 2 - большие 5х7
            set_CLOCK_SIZE(intData[2]);
            checkClockOrigin();
            // Шрифт отображения температуры в эффекте Погода зависит от установленного размера часов
            if (thisMode == MC_WEATHER) {
              loadingFlag = true;
            }
            break;
          case 8:               // $19 8 YYYY MM DD HH MM; - Установить текущее время YYYY.MM.DD HH:MM
            setCurrentTime((uint8_t)intData[5], (uint8_t)intData[6], 0, (uint8_t)intData[4], (uint8_t)intData[3], (uint16_t)intData[2]);
            break;
          case 9:               // $19 9 X; - Показывать температуру в режиме часов  X: 0 - нет, 1 - да
            if (allowHorizontal || allowVertical) {
              set_showWeatherInClock(intData[2] == 1);
            } else {
              set_showWeatherInClock(false);
            }
            break;
          case 10:               // $19 10 X; - Цвет ночных часов:  0 - R; 1 - G; 2 - B; 3 - C; 3 - M; 5 - Y; 6 - W;
            set_nightClockColor(intData[2]);
            if (isNightClock) {
              set_specialBrightness(nightClockBrightness);
              FastLED.setBrightness(specialBrightness);
            }
            break;
          case 11:               // $19 11 X; - Яркость ночных часов:  1..255;
            set_nightClockBrightness(intData[2]); // setter
            if (isNightClock) {
              set_specialBrightness(nightClockBrightness);
              FastLED.setBrightness(specialBrightness);
            }
            break;
          case 12:               // $19 12 X; - скорость прокрутки часов оверлея или 0, если часы остановлены по центру
            set_clockScrollSpeed(255 - intData[2]);
            setTimersForMode(thisMode);
            break;
          case 14:               // $19 14 00FFAA;
            // В строке цвет - "$19 14 00FFAA;" - цвет часов оверлея, сохраняемый в globalClockColor
            str = String(incomeBuffer).substring(7, 13);
            set_globalClockColor((uint32_t)HEXtoInt(str));
            break;
          case 16:               // $19 16 X; - Показывать дату в режиме часов  X: 0 - нет, 1 - да
            if (allowHorizontal || allowVertical) {
              set_showDateInClock(intData[2] == 1);
            } else {
              set_clockOverlayEnabled(false);
              set_showDateInClock(false);
            }
            break;
          case 17:               // $19 17 D I; - Продолжительность отображения даты / часов (в секундах)
            set_showDateDuration(intData[2]);
            set_showDateInterval(intData[3]);
            break;
          case 18:               // $19 18 HH MM TT; - Установить указанное время HH:MM и температуру TT - для отладки позиционирования часов с температурой
            debug_hours = intData[2];
            debug_mins = intData[3];
            debug_temperature = intData[4];
            break;
          default:
            err = true;
#if (USE_MQTT == 1)
            notifyUnknownCommand(incomeBuffer);
#endif
            break;
        }
        if (!err) {
          // Для команд, пришедших от MQTT отправлять только ACK;
          // Для команд, пришедших от UDP отправлять при необходимости другие данные, например - состояние элементов управления на странице от которой пришла команда
          if (cmdSource == UDP) {
            if (intData[1] != 8) {
              sendPageParams(4, cmdSource);
            } else {
              sendAcknowledge(cmdSource);
            }
          } else {
            sendAcknowledge(cmdSource);
          }
        }
        break;

      // ----------------------------------------------------
      //  20 - настройки и управление будильников
      // - $20 0;       - отключение будильника (сброс состояния isAlarming)
      // - $20 2 X VV MA MB;
      //      X    - исп звук будильника X=0 - нет, X=1 - да
      //     VV    - максимальная громкость
      //     MA    - номер файла звука будильника
      //     MB    - номер файла звука рассвета
      // - $20 3 X NN VV; - пример звука будильника
      //      X - 1 играть 0 - остановить
      //     NN - номер файла звука будильника из папки SD:/01
      //     VV - уровень громкости
      // - $20 4 X NN VV; - пример звука рассвета
      //      X - 1 играть 0 - остановить
      //     NN - номер файла звука рассвета из папки SD:/02
      //     VV - уровень громкости
      // - $20 5 VV; - установит уровень громкости проигрывания примеров (когда уже играет)
      //     VV - уровень громкости
      // ----------------------------------------------------

      case 20:
        switch (intData[1]) {
          case 0:
            // $20 0;       - отключение будильника (сброс состояния isAlarming)
            if (isAlarming || isPlayAlarmSound) stopAlarm();
            break;
          case 2:
#if (USE_MP3 == 1)
            if (isDfPlayerOk) {
              // $20 2 X VV MA MB;
              //    X    - исп звук будильника X=0 - нет, X=1 - да
              //   VV    - максимальная громкость
              //   MA    - номер файла звука будильника
              //   MB    - номер файла звука рассвета
              dfPlayer.stop(); delay(GUARD_DELAY);
              set_soundFolder(0);
              set_soundFile(0);
              set_isAlarming(false);
              set_isAlarmStopped(false);
              set_useAlarmSound(intData[2] == 1);
              set_maxAlarmVolume(constrain(intData[3], 0, 30));
              set_alarmSound(intData[4] - 2);  // Индекс от приложения: 0 - нет; 1 - случайно; 2 - 1-й файл; 3 - ... -> -1 - нет; 0 - случайно; 1 - 1-й файл и т.д
              set_dawnSound(intData[5] - 2);   // Индекс от приложения: 0 - нет; 1 - случайно; 2 - 1-й файл; 3 - ... -> -1 - нет; 0 - случайно; 1 - 1-й файл и т.д
            }
#endif
            break;
          case 3:
#if (USE_MP3 == 1)
            if (isDfPlayerOk) {
              // $20 3 X NN VV; - пример звука будильника
              //  X  - 1 играть 0 - остановить
              //  NN - номер файла звука будильника из папки SD:/01
              //  VV - уровень громкости
              if (intData[2] == 0) {
                StopSound(0);
                set_soundFolder(0);
                set_soundFile(0);
              } else {
                b_tmp = intData[3] - 2;  // Знач: -1 - нет; 0 - случайно; 1 и далее - файлы; -> В списке индексы: 1 - нет; 2 - случайно; 3 и далее - файлы
                if (b_tmp > 0 && b_tmp <= alarmSoundsCount) {
                  dfPlayer.stop(); delay(GUARD_DELAY);
                  set_soundFolder(1);
                  set_soundFile(b_tmp);
                  dfPlayer.setVolume(constrain(intData[4], 0, 30));   delay(GUARD_DELAY);
                  dfPlayer.playFolderTrack(soundFolder, soundFile); delay(GUARD_DELAY);
                  dfPlayer.setRepeatPlayCurrentTrack(true);         delay(GUARD_DELAY);
                } else {
                  set_soundFolder(0);
                  set_soundFile(0);
                }
              }
            }
#endif
            break;
          case 4:
#if (USE_MP3 == 1)
            if (isDfPlayerOk) {
              // $20 4 X NN VV; - пример звука рассвета
              //    X  - 1 играть 0 - остановить
              //    NN - номер файла звука рассвета из папки SD:/02
              //    VV - уровень громкости
              if (intData[2] == 0) {
                StopSound(0);
                set_soundFolder(0);
                set_soundFile(0);
              } else {
                dfPlayer.stop(); delay(GUARD_DELAY);
                b_tmp = intData[3] - 2; // Знач: -1 - нет; 0 - случайно; 1 и далее - файлы; -> В списке индексы: 1 - нет; 2 - случайно; 3 и далее - файлы
                if (b_tmp > 0 && b_tmp <= dawnSoundsCount) {
                  set_soundFolder(2);
                  set_soundFile(b_tmp);
                  dfPlayer.setVolume(constrain(intData[4], 0, 30));   delay(GUARD_DELAY);
                  dfPlayer.playFolderTrack(soundFolder, soundFile); delay(GUARD_DELAY);
                  dfPlayer.setRepeatPlayCurrentTrack(true);         delay(GUARD_DELAY);
                } else {
                  set_soundFolder(0);
                  set_soundFile(0);
                }
              }
            }
#endif
            break;
          case 5:
#if (USE_MP3 == 1)
            if (isDfPlayerOk && soundFolder > 0) {
              // $20 5 VV; - установить уровень громкости проигрывания примеров (когда уже играет)
              //    VV - уровень громкости
              set_maxAlarmVolume(constrain(intData[2], 0, 30));
              dfPlayer.setVolume(maxAlarmVolume); delay(GUARD_DELAY);
            }
#endif
            break;
          default:
            err = true;
#if (USE_MQTT == 1)
            notifyUnknownCommand(incomeBuffer);
#endif
            break;
        }
        if (!err) {
          // Для команд, пришедших от MQTT отправлять только ACK;
          // Для команд, пришедших от UDP отправлять при необходимости другие данные, например - состояние элементов управления на странице от которой пришла команда
          if (cmdSource == UDP) {
            if (intData[1] == 0) {
              sendPageParams(5, cmdSource);
            } else if (intData[1] == 1 || intData[1] == 2) { // Режимы установки параметров - сохранить
              sendPageParams(5, cmdSource);
            } else {
              sendPageParams(96);
            }
          } else {
            sendAcknowledge(cmdSource);
          }
        }
        break;

      // ----------------------------------------------------
      // 21 - настройки подключения к сети / точке доступа
      //   $21 0 0 - не использовать точку доступа $21 0 1 - использовать точку доступа
      //   $21 1 IP1 IP2 IP3 IP4 - установить статический IP адрес подключения к локальной WiFi сети, пример: $21 1 192 168 0 106
      //   $21 2; Выполнить переподключение к сети WiFi
      // ----------------------------------------------------

      case 21:
        // Настройки подключения к сети
        switch (intData[1]) {
          // $21 0 0 - не использовать точку доступа $21 0 1 - использовать точку доступа
          case 0:
            set_useSoftAP(intData[2] == 1);
            if (useSoftAP && !ap_connected)
              startSoftAP();
            else if (!useSoftAP && ap_connected) {
              if (wifi_connected) {
                ap_connected = false;
                WiFi.softAPdisconnect(true);
                DEBUGLN(F("Точка доступа отключена."));
              }
            }
            break;
          case 1:
            // $21 1 IP1 IP2 IP3 IP4 - установить статический IP адрес подключения к локальной WiFi сети, пример: $21 1 192 168 0 106
            // Локальная сеть - 10.х.х.х или 172.16.х.х - 172.31.х.х или 192.168.х.х
            // Если задан адрес не локальной сети - сбросить его в 0.0.0.0, что означает получение динамического адреса
            if (!(intData[2] == 10 || (intData[2] == 172 && intData[3] >= 16 && intData[3] <= 31) || (intData[2] == 192 && intData[3] == 168))) {
              set_StaticIP(0, 0, 0, 0);
            }
            set_StaticIP(intData[2], intData[3], intData[4], intData[5]);
            break;
          case 2:
            // $21 2; Выполнить переподключение к сети WiFi
            saveSettings();
            delay(10);
            FastLED.clear();
            startWiFi(5000);     // Время ожидания подключения 5 сек
            showCurrentIP(true);
            break;
          default:
            err = true;
#if (USE_MQTT == 1)
            notifyUnknownCommand(incomeBuffer);
#endif
            break;
        }
        if (!err) {
          // Для команд, пришедших от MQTT отправлять только ACK;
          // Для команд, пришедших от UDP отправлять при необходимости другие данные, например - состояние элементов управления на странице от которой пришла команда
          if (cmdSource == UDP) {
            if (intData[1] == 0 || intData[1] == 1) {
              sendAcknowledge(cmdSource);
            } else {
              sendPageParams(6, cmdSource);
            }
          } else {
            sendAcknowledge(cmdSource);
          }
        }
        break;

      // ----------------------------------------------------
      // 22 - настройки включения режимов матрицы в указанное время NN5 - Действие на "Рассвет", NN6 - действие на "Закат"
      // - $22 HH1 MM1 NN1 HH2 MM2 NN2 HH3 MM3 NN3 HH4 MM4 NN4 NN5 NN6
      //     HHn - час срабатывания
      //     MMn - минуты срабатывания
      //     NNn - эффект: -3 - выключено; -2 - выключить матрицу; -1 - ночные часы; 0 - случайный режим и далее по кругу; 1 и далее - список режимов EFFECT_LIST
      // ----------------------------------------------------

      case 22:
        set_AM1_hour(intData[1]);
        set_AM1_minute(intData[2]);
        set_AM1_effect_id(intData[3]);

        set_AM2_hour(intData[4]);
        set_AM2_minute(intData[5]);
        set_AM2_effect_id(intData[6]);

        set_AM3_hour(intData[7]);
        set_AM3_minute(intData[8]);
        set_AM3_effect_id(intData[9]);

        set_AM4_hour(intData[10]);
        set_AM4_minute(intData[11]);
        set_AM4_effect_id(intData[12]);

        set_dawn_effect_id(intData[13]);   // Действие на время "Рассвет"
        set_dusk_effect_id(intData[14]);   // Действие на время "Закат"

        saveSettings();

        // Для команд, пришедших от MQTT отправлять только ACK;
        // Для команд, пришедших от UDP отправлять при необходимости другие данные, например - состояние элементов управления на странице от которой пришла команда
        if (cmdSource == UDP) {
          sendPageParams(7, cmdSource);
        } else {
          sendAcknowledge(cmdSource);
        }
        break;

      // ----------------------------------------------------
      // 23 - прочие настройки
      // - $23 0 VAL  - лимит по потребляемому току
      // - $23 1 ST   - Сохранить EEPROM в файл    ST = 0 - внутр. файл. систему; 1 - на SD-карту
      // - $23 2 ST   - Загрузить EEPROM из файла  ST = 0 - внутр. файл. системы; 1 - на SD-карты
      // - $23 3 E1 E2 E3   - Установка режима работы панели и способа трактовки полученных данных синхронизации
      //       E1 - режим работы 0 - STANDALONE; 1 - MASTER; 2 - SLAVE
      //       E2 - данные в кадре: 0 - физическое расположение цепочки диодов
      //                            1 - логическое расположение - X,Y - 0,0 - левый верхний угол и далее вправо по X, затем вниз по Y
      //                            2 - payload пакета - строка команды
      //       E3 - группа синхронизации 0..9
      // ----------------------------------------------------

      case 23:
        // $23 0 VAL - лимит по потребляемому току
        // $23 1 ST   - Сохранить EEPROM в файл    ST = 0 - внутр. файл. систему; 1 - на SD-карту
        // $23 2 ST   - Загрузить EEPROM из файла  ST = 0 - внутр. файл. системы; 1 - на SD-карты
        // $23 3 E1 E2 E3   - Установка режима работы панели и способа трактовки полученных данных синхронизации
        //     E1 - режим работы 0 - STANDALONE; 1 - MASTER; 2 - SLAVE
        //     E2 - данные в кадре: 0 - физическое расположение цепочки диодов
        //                          1 - логическое расположение - X,Y - 0,0 - левый верхний угол и далее вправо по X, затем вниз по Y
        //                          2 - payload пакета - строка команды
        //     E3 - группа синхронизации 0..9
        switch (intData[1]) {
          case 0:
            set_CURRENT_LIMIT(intData[2]);
            FastLED.setMaxPowerInVoltsAndMilliamps(5, CURRENT_LIMIT == 0 ? 100000 : CURRENT_LIMIT);
            sendAcknowledge(cmdSource);
            break;
          case 1:
            err = !saveEepromToFile(intData[2] == 1 ? "SD" : "FS");
            if (err) {
              str = F("$18 ER:[E~Не удалось сохранить резервную копию настроек]|EE:");
            } else {
              str = F("$18 ER:[I~Резервная копия настроек создана]|EE:");
            }
            str += String(eeprom_backup) + ";";
            sendStringData(str, cmdSource);
            break;
          case 2:
            err = !loadEepromFromFile(intData[2] == 1 ? "SD" : "FS");
            if (err) {
              str = F("$18 ER:[E~Не удалось загрузить резервную копию настроек];");
            } else {
              str = F("$18 ER:[I~Настройки из резервной копии восстановлены];");
            }
            sendStringData(str, cmdSource);
            // Если настройки загружены без ошибок - перезагрузить устройство
            if (!err) {
              delay(500);
              ESP.restart();
            }
            break;
          case 3:
#if (USE_E131 == 1)
            // Переинициализировать не нужно, если изменился только syncMode с PHYSIC на LOGIC или наоборот
            {
              bool needReInitialize = workMode != (eWorkModes)intData[2] || syncGroup != intData[4] || !((syncMode == PHYSIC && ((eSyncModes)intData[3] == LOGIC)) || (syncMode == LOGIC && (eSyncModes)intData[3] == PHYSIC));
              set_SyncWorkMode((eWorkModes)intData[2]);
              set_SyncDataMode((eSyncModes)intData[3]);
              set_SyncGroup(intData[4]);
              saveSettings();
              if (needReInitialize) {
                DisposeE131();
                InitializeE131();
              } else {
                printWorkMode();
              }
              // Для команд, пришедших от MQTT отправлять только ACK;
              // Для команд, пришедших от UDP отправлять при необходимости другие данные, например - состояние элементов управления на странице от которой пришла команда
              if (cmdSource == UDP) {
                sendPageParams(9, cmdSource);
              } else {
                sendAcknowledge(cmdSource);
              }
            }
#endif
            break;
          default:
            err = true;
#if (USE_MQTT == 1)
            notifyUnknownCommand(incomeBuffer);
#endif
            break;
        }
        break;

      // ----------------------------------------------------
      default:
#if (USE_MQTT == 1)
        notifyUnknownCommand(incomeBuffer);
#endif
        break;

    }
  }

  // ****************** ПАРСИНГ *****************

  // Если предыдущий буфер еще не разобран - новых данных из сокета не читаем, продолжаем разбор уже считанного буфера
  haveIncomeData = bufIdx > 0 && bufIdx < packetSize;

#if (USE_MQTT == 1)
  if (!haveIncomeData) {
    // Есть ли поступившие по каналу MQTT команды?
    if (queueLength > 0) {
      String command = cmdQueue[queueReadIdx++];
      if (queueReadIdx >= QSIZE_IN) queueReadIdx = 0;
      queueLength--;

      cmdSource = MQTT;
      haveIncomeData = true;
      bufIdx = 0;
      packetSize = command.length();
      memcpy(incomeBuffer, command.c_str(), packetSize);

      DEBUG(F("MQTT пакeт размером "));
      DEBUGLN(packetSize);
    }
  }
#endif

  if (!haveIncomeData) {
    packetSize = udp.parsePacket();
    haveIncomeData = packetSize > 0;

    if (haveIncomeData) {
      // read the packet into packetBufffer
      int16_t len = udp.read(incomeBuffer, BUF_MAX_SIZE);
      if (len > 0) {
        incomeBuffer[len] = 0;
      }
      bufIdx = 0;

      cmdSource = UDP;

      delay(0);            // ESP8266 при вызове delay отрабатывает стек IP протокола, дадим ему поработать

      DEBUG(F("UDP << ip='"));
      IPAddress remote = udp.remoteIP();
      DEBUG(remote.toString());
      DEBUG(":");
      DEBUG(udp.remotePort());
      DEBUG("'");
      if (udp.remotePort() == localPort) {
        DEBUG(F("; cmd='"));
        DEBUG(incomeBuffer);
        DEBUG("'");
      }
      if (udp.remotePort() == 123) {
        DEBUG(F("; ntp sync"));
      }
      DEBUGLN();

      DEBUG(F("Получен UDP пакeт размером "));
      DEBUGLN(packetSize);
    }

    // NTP packet from time server
    if (haveIncomeData && udp.remotePort() == 123) {
      parseNTP();
      haveIncomeData = false;
      bufIdx = 0;
    }
  }// !haveIncomeData UDP

  if (haveIncomeData) {

    // Из-за ошибки в компоненте UdpSender в Thunkable - теряются половина отправленных
    // символов, если их кодировка - двухбайтовый UTF8, т.к. оно вычисляет длину строки без учета двухбайтовости
    // Чтобы символы не терялись - при отправке строки из андроид-программы, она добивается с конца пробелами
    // Здесь эти конечные пробелы нужно предварительно удалить
    while (packetSize > 0 && incomeBuffer[packetSize - 1] == ' ') packetSize--;
    incomeBuffer[packetSize] = 0;

    if (parseMode == TEXT) {                         // если нужно принять строку - принимаем всю

      // Оставшийся буфер преобразуем с строку
      if (intData[0] == 6) {  // текст
        receiveText = String(&incomeBuffer[bufIdx]);
        receiveText.trim();
      }

      incomingByte = ending;                       // сразу завершаем парс
      parseMode = NORMAL;
      bufIdx = 0;
      packetSize = 0;                              // все байты из входящего пакета обработаны
    } else {
      incomingByte = incomeBuffer[bufIdx++];       // обязательно ЧИТАЕМ входящий символ
    }
  }

  if (haveIncomeData) {

    if (parseStarted) {                                             // если приняли начальный символ (парсинг разрешён)
      if (incomingByte != divider && incomingByte != ending) {      // если это не пробел И не конец
        string_convert += incomingByte;                             // складываем в строку
      } else {                                                      // если это пробел или ; конец пакета
        if (parse_index == 0) {
          uint8_t cmdMode = string_convert.toInt();
          intData[0] = cmdMode;
          if (cmdMode == 6) {
            parseMode = TEXT;
          }
          else parseMode = NORMAL;
        }
 
        if (parse_index == 1) {       // для второго (с нуля) символа в посылке
          if (parseMode == NORMAL) intData[parse_index] = string_convert.toInt();           // преобразуем строку в int и кладём в массив}
          if (parseMode == COLOR) {                                                         // преобразуем строку HEX в цифру
            set_globalColor((uint32_t)HEXtoInt(string_convert));
            if (intData[0] == 0) {
              incomingByte = ending;
              parseStarted = false;
            } else {
              parseMode = NORMAL;
            }
          }
        } else {
          intData[parse_index] = string_convert.toInt();  // преобразуем строку в int и кладём в массив
        }
        string_convert = "";                        // очищаем строку
        parse_index++;                              // переходим к парсингу следующего элемента массива
      }
    }

    if (incomingByte == header) {                   // если это $
      parseStarted = true;                          // поднимаем флаг, что можно парсить
      parse_index = 0;                              // сбрасываем индекс
      string_convert = "";                          // очищаем строку
    }

    if (incomingByte == ending) {                   // если таки приняли ; - конец парсинга
      parseMode = NORMAL;
      parseStarted = false;                         // сброс
      recievedFlag = true;                          // флаг на принятие
      bufIdx = 0;
    }

    if (bufIdx >= packetSize) {                     // Весь буфер разобран
      bufIdx = 0;
      packetSize = 0;
    }
  }
}

void sendPageParams(uint8_t page) {
  sendPageParams(page, BOTH);
}

void sendPageParams(uint8_t page, eSources src) {

  String str = "", color, text;
  CRGB   c1, c2;
  bool   err = false;

  switch (page) {
    case 1:  // Настройки
      str = getStateString("UP|FM|AL|W|H|DM|PS|PD|IT|RM|PW|BR|WU|WT|WR|WS|WC|WN|WZ|SD|FS|EE");
      break;
    case 2:  // Эффекты
      str = getStateString("UP|FM|AL|EF|EN|UE|UT|UC|SE|SS|BE|SQ");
      break;
    case 3:  // Настройки бегущей строки
      str = getStateString("UP|FM|AL|TE|TI|CT|ST|C2|OM|TS");
      break;
    case 4:  // Настройки часов
      str = getStateString("UP|FM|AL|CE|CC|CO|CK|NC|SC|C1|DC|DD|DI|NP|NT|NZ|NS|DW|OF|TM");
      break;
    case 5:  // Настройки будильника
      str = getStateString("UP|FM|AL|AW|AT|AD|AE|MX|MU|MD|MV|MA|MB|MP");
      break;
    case 6:  // Настройки подключения
      str = getStateString("UP|FM|AL|AU|AN|AA|NW|NA|IP|QZ|QA|QP|QS|QU|QW|QD|QR|QK");
      break;
    case 7:  // Настройки режимов автовключения по времени
      str = getStateString("UP|FM|AL|WZ|WU|AM1T|AM1A|AM2T|AM2A|AM3T|AM3A|AM4T|AM4A|AM5A|AM6A|T1|T2");
      break;
    case 8:  // Настройки параметров матрицы (размеры, подключение)
      str = getStateString("UP|FM|AL|M0|M1|M2|M3|M4|M5|M6|M7|M8|M9|M10|M11");
      break;
    case 9:  // Настройки параметров синхронизации
      str = getStateString("UP|FM|AL|E0|E1|E2|E3");
      break;
    case 10:  // Загрузка картинок
      str = getStateString("UP|FM|W|H|BR|CL|SD");
      break;
    case 11:  // Рисование
      str = getStateString("UP|FM|W|H|BR|CL|SD|FS");
      break;
    case 12:  // Игры
      str = getStateString("UP|FM|W|H|BR|SE|SD");
      break;
    case 91:  // Запрос текста бегущей строки для редактирования указанной ячейки или замены строки текста в списке ячейки
      str = getStateString("TS|TY");
      addKeyToChanged("TY");       // Отправить также строку в канал MQTT
      addKeyToChanged("TS");       // Текст в строке мог быть изменен - отправить в канал MQTT состояние строк
      break;
#if (USE_MP3 == 1)
    case 92:  // Запрос списка звуков бегущей строки
      str = getStateString("S3");
      break;
    case 93:  // Запрос списка звуков будильника
      str = getStateString("S1");
      break;
    case 94:  // Запрос списка звуков рассвета
      str = getStateString("S2");
      break;
#else
    case 92:  // Запрос списка звуков бегущей строки
    case 93:  // Запрос списка звуков будильника
    case 94:  // Запрос списка звуков рассвета
      // Если MP3-плеер отключен - просто игнорировать
      break;
#endif
    case 95:  // Ответ состояния будильника - сообщение по инициативе сервера
      str = getStateString("AL");
      cmd95 = str;
      src = BOTH;
      break;
    case 96:  // Ответ демо-режима звука - сообщение по инициативе сервера
      str = getStateString("MP");
      cmd96 = str;
      src = BOTH;
      break;
    case 97:  // Запрос списка эффектов с SD-карты
#if (USE_SD == 1)
      str = getStateString("LF");
#endif
      break;
    case 98:  // Запрос всех строк текста бегущей строки
      str = getStateString("LT");
      break;
    case 99:  // Запрос списка эффектов
      str = getStateString("LE");
      break;
    default:
      err = true;
#if (USE_MQTT == 1)
      DynamicJsonDocument doc(256);
      String out;
      doc["message"] = F("unknown page");
      doc["text"]    = String(F("нет страницы с номером ")) + String(page);
      serializeJson(doc, out);
      SendMQTT(out, TOPIC_ERR);
#endif
      break;
  }

  if (!err) {
    if (str.length() > 0) {
      // Отправить клиенту запрошенные параметры страницы / режимов
      str = "$18 " + str + ";";
      sendStringData(str, src);
    } else {
      sendAcknowledge(cmdSource);
    }
  }
}

void sendStringData(String &str, eSources src) {
#if (USE_MQTT == 1)
  if (src == MQTT || src == BOTH) {
    SendMQTT(str, TOPIC_DTA);
  }
#endif
  if (src == UDP || src == BOTH) {
    uint16_t max_text_size = sizeof(incomeBuffer);        // Размер приемного буфера формирования текста загружаемой / отправляемой строки
    memset(incomeBuffer, '\0', max_text_size);
    str.toCharArray(incomeBuffer, str.length() + 1);
    udp.beginPacket(udp.remoteIP(), udp.remotePort());
    udp.write((const uint8_t*) incomeBuffer, str.length() + 1);
    udp.endPacket();
    delay(0);
    DEBUGLN(String(F("UDP ")) + udp.remoteIP().toString() + ":" + String(udp.remotePort()) + " >> " + String(incomeBuffer));
  }
}

//~ добавлен код для Brain Ring //!
void sendUDPtoBrainRing() {
  udp.beginPacket(BrainRingServerIP, BrainRingServerPORT);
  //or
  //  char charBuffer[5];
  //  memset(charBuffer, '\0', 5); // 5 bytes
  //  str.toCharArray(charBuffer, str.length() + 1);
  //  udp.write((const uint8_t*) charBuffer, str.length() + 1);
  //or
  //  udp.printf(str);
  //or
  udp.write((const uint8_t*) udpBrainRingButt, 11);
  udp.endPacket();
  udp.flush();
  delay(0);
  Serial.println(F("\n\n UDP to Brain Ring sent"));
}//sendUDPtoBrainRing()
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
