nicelight/Brain_Ring-/(commit log)

2023-11-23 initialisation
    взят форк юзера vvip-68. Ничего не изменено кроме статического айпишника, вайфай сети и основных преднастроек в дефайнах.
2023-12-02 update
    обновление схемки под наш проект
2023-12-13 init
    первая версия прошивки, написал, оттестировал и отправил в новосибирск. Работает 10 + 10 кнопок зоны Relax, зона игра, зона Disco 10+10 кнопок.
2023-12-29 update
    не был файл обновлен
2023-12-29 up to date
    было несоответствие
2024-01-09 поддержка мультинажатий
    теперь игроки могут сколько хочешь раз бахать по кнопкам, это не важно. Правильный ответ зачтется той команде, которую выберет админ в веб интерфейсе.
    Правильный ответ можно выбирать даже без нажатий на кнопку. Главное, чтобы игра была запущена.
2024-01-11 v1.1 мультинажатия на кнопки
    админ может накидывать балы командам независимо от нажатий. Кнопки можно прожимать несколько раз
2024-01-12 световая реакция на нажатие кнопки
    по тригеру на эффект №44
2024-02-15 check sinchro
    проверяем на сколько актуальный файл у меня в рабочем воркспейсе был?
2024-02-15 разделил на два файла сырцы
    теперь рука в своем живет, кнопки в своем
2024-02-15 разделение по файлам
    каждой плате свой env и свой код. Класс!!!
2024-02-15 звуковой пульт
    прошивка
2024-03-04 тест пульта
2024-03-04 DJ remote инфо
2024-03-04 пульт диджея добавлен
